araujoB105/BWRCprostheticArm/pictures/fingers.jpg

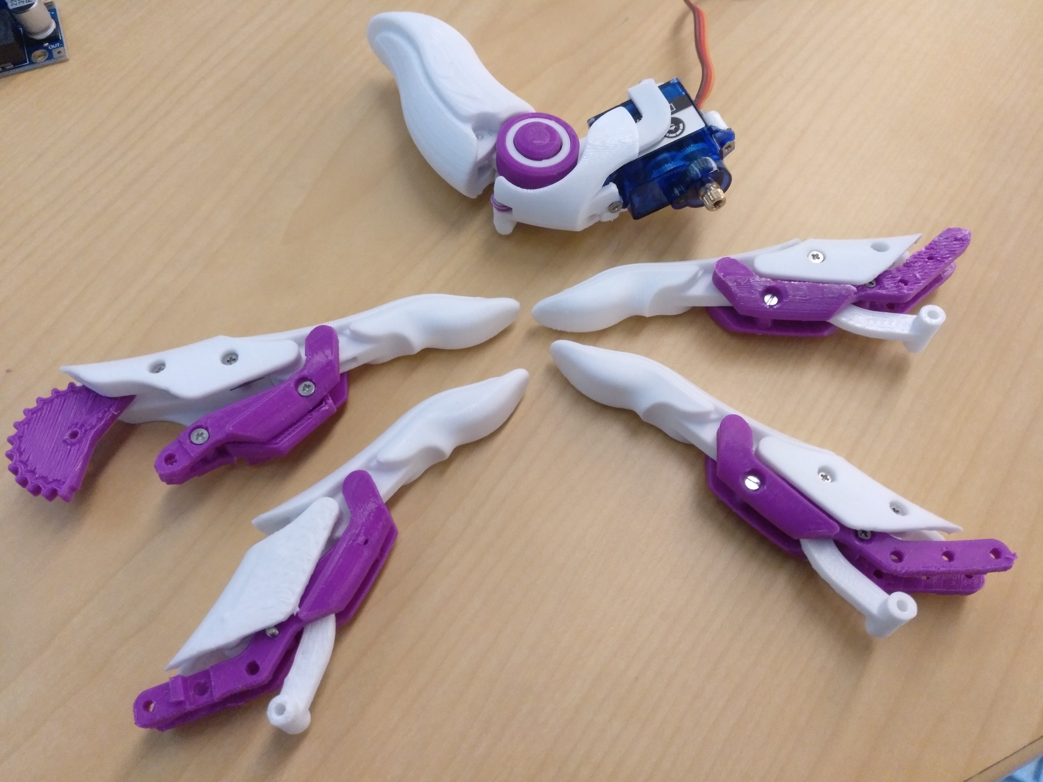
pictures/fingers.jpg
