araujoB105/BWRCprostheticArm/pictures/IMG_20180503_151149_356.jpg

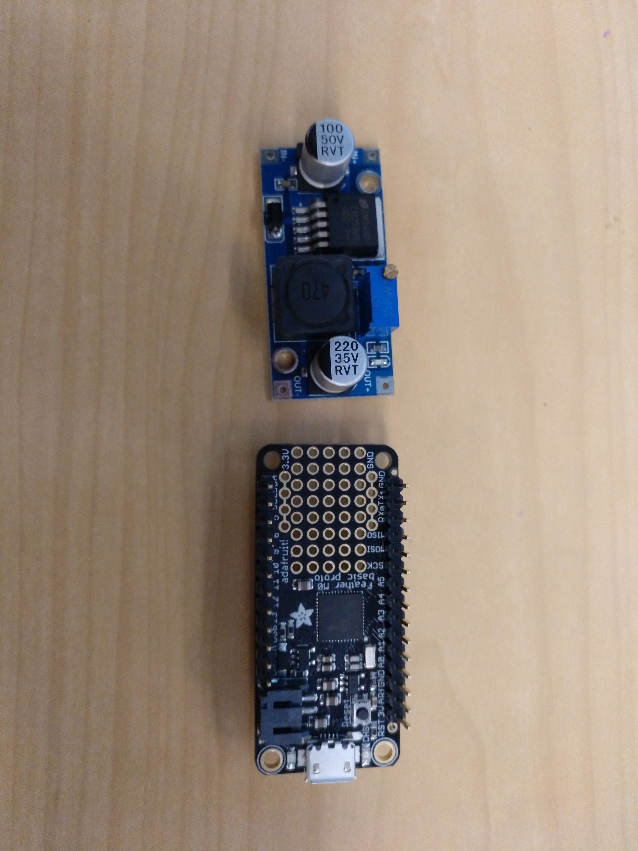
pictures/IMG_20180503_151149_356.jpg
