araujoB105/BWRCprostheticArm/pictures/battery_holder.jpg

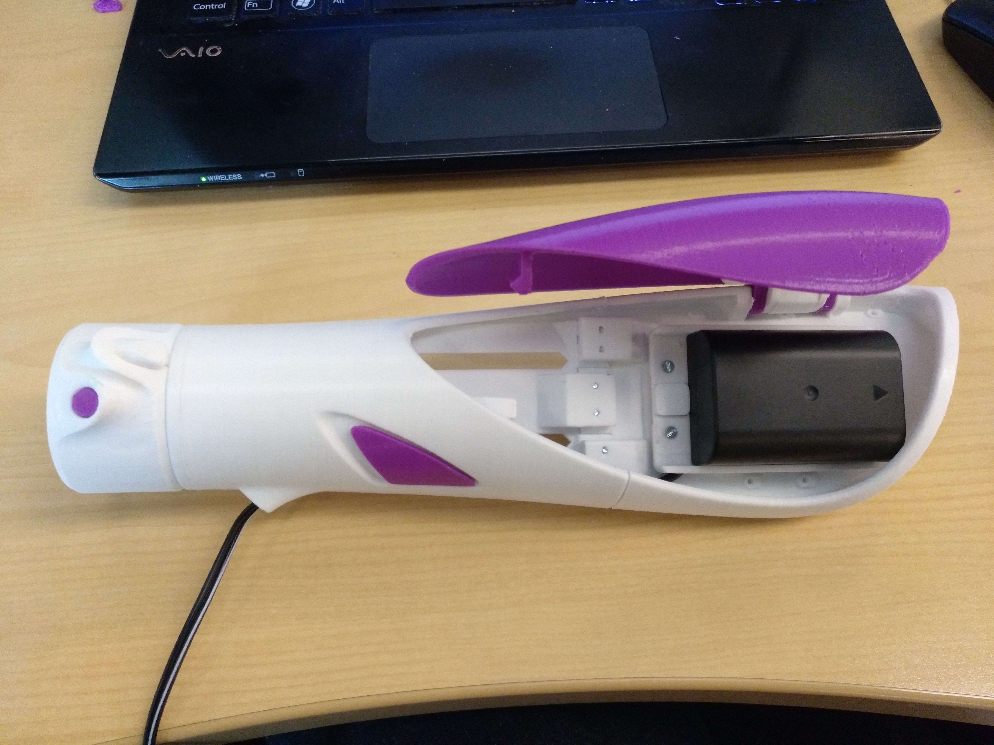
pictures/battery_holder.jpg
