araujoB105/BWRCprostheticArm/pictures/creation.jpg

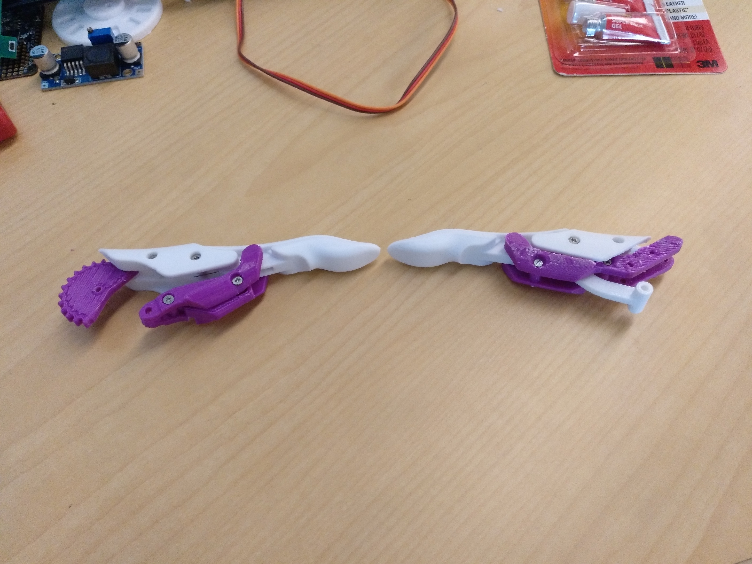
pictures/creation.jpg
