araujoB105/BWRCprostheticArm/pictures/driver.jpg

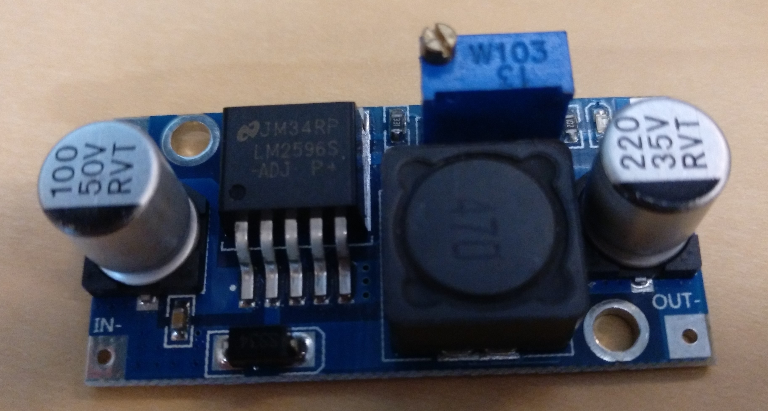
pictures/driver.jpg
