araujoB105/BWRCprostheticArm/pictures/feather.jpg

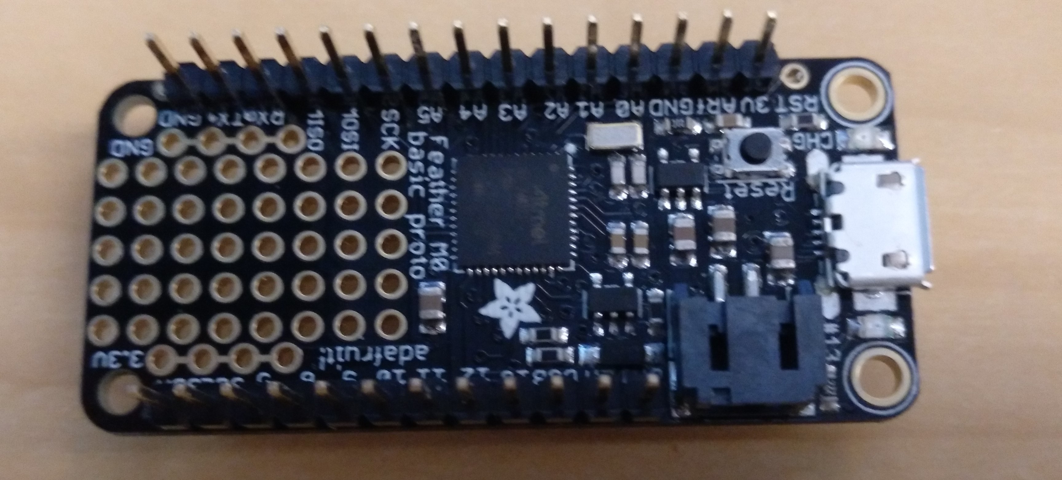
pictures/feather.jpg
