araujoB105/BWRCprostheticArm/pictures/full_arm2.jpg

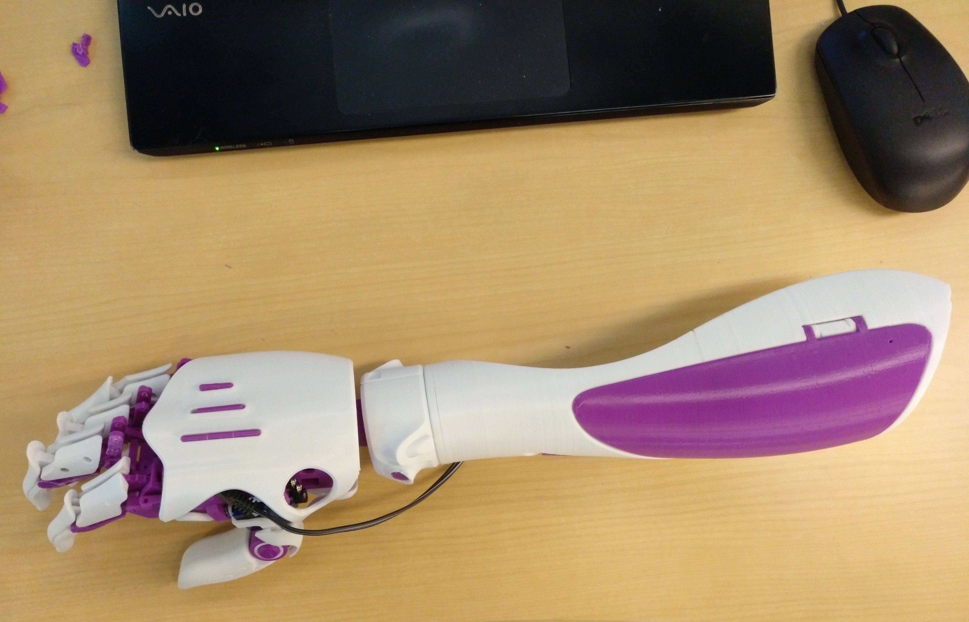
pictures/full_arm2.jpg
