araujoB105/BWRCprostheticArm/pictures/full_arm.jpg

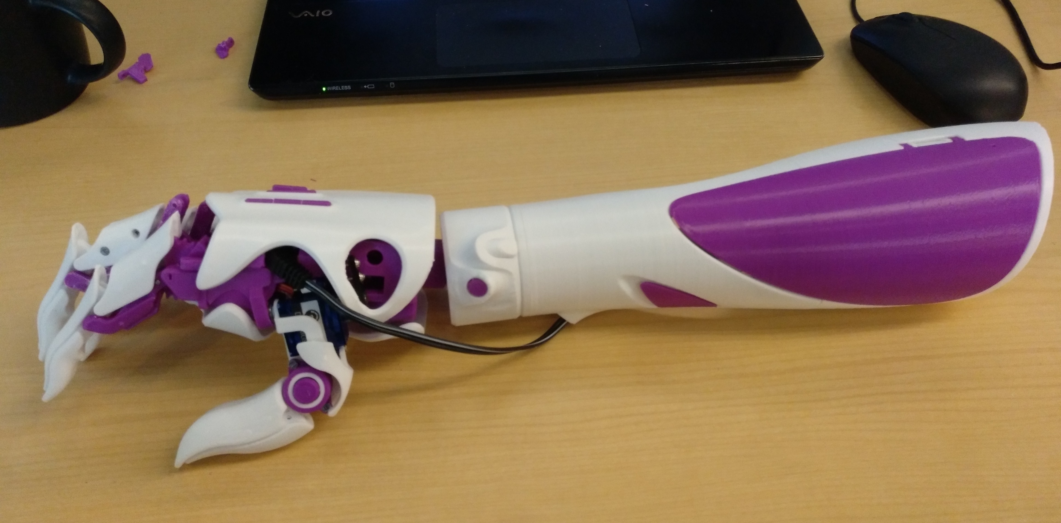
pictures/full_arm.jpg
