araujoB105/BWRCprostheticArm/pictures/hand_detail.jpg

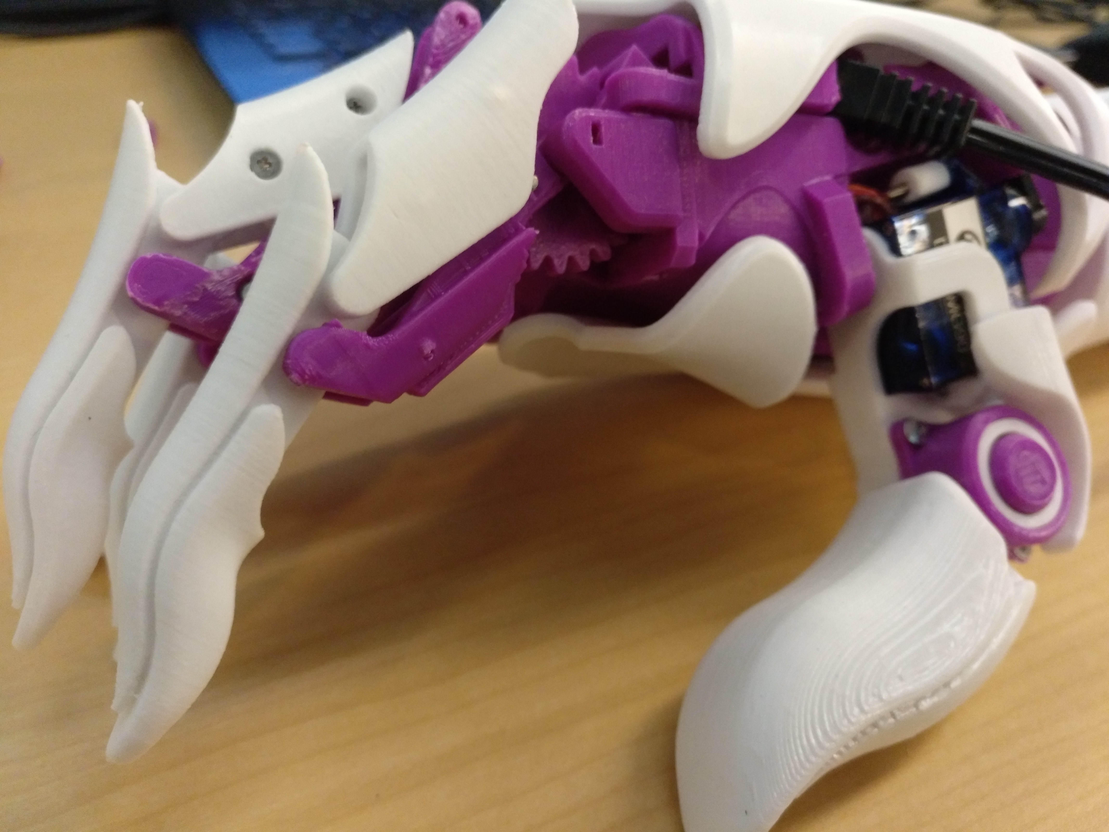
pictures/hand_detail.jpg
