araujoB105/BWRCprostheticArm/pictures/hand_OK.jpg

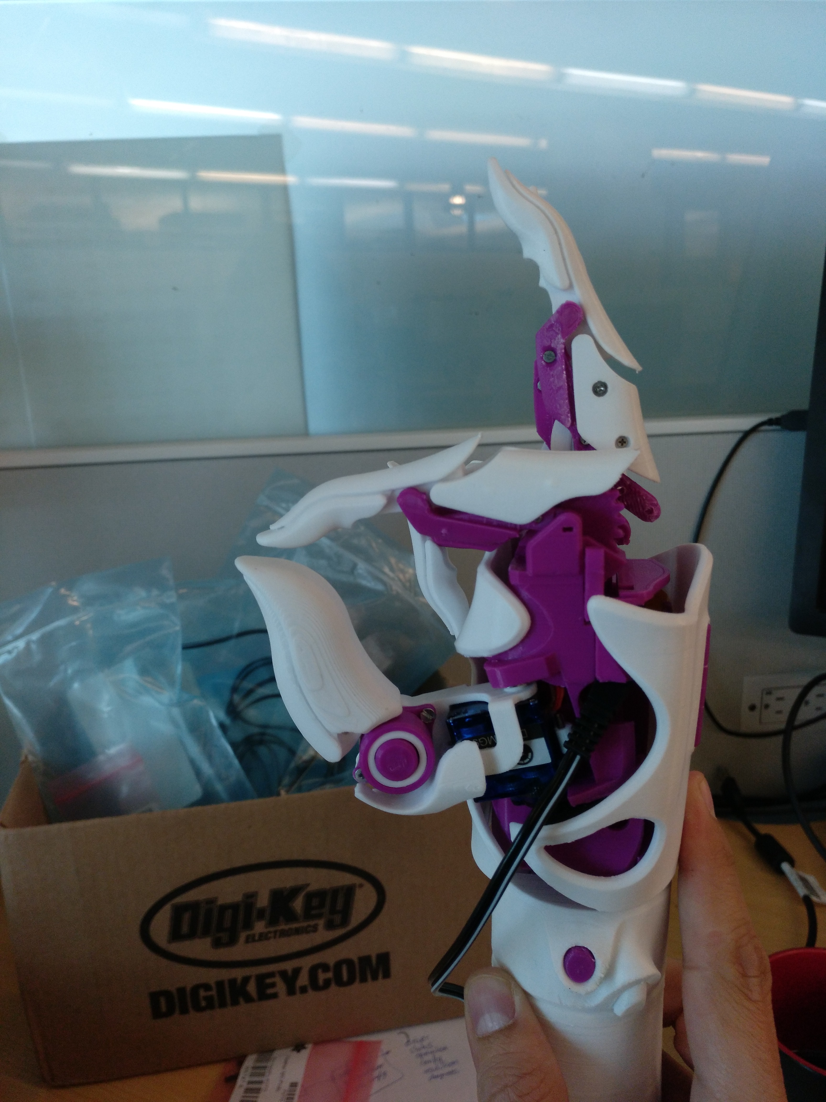
pictures/hand_OK.jpg
