araujoB105/BWRCprostheticArm/pictures/handBoard.jpg

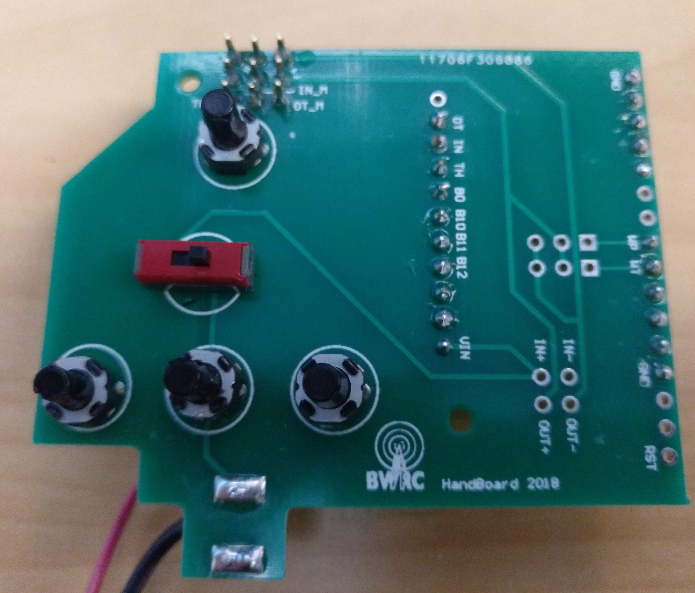
pictures/handBoard.jpg
