araujoB105/BWRCprostheticArm/pictures/IMG_20180503_150604_703.jpg

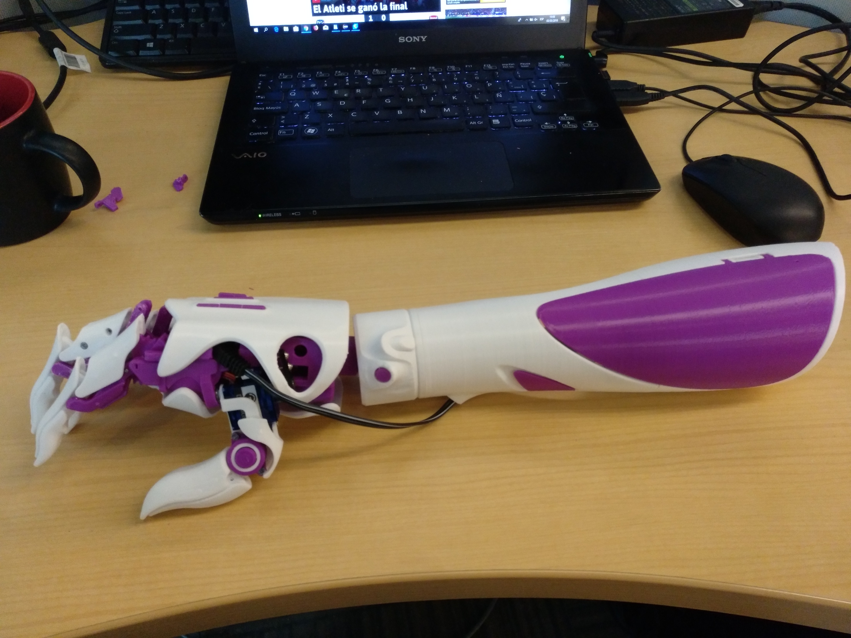
pictures/IMG_20180503_150604_703.jpg
