araujoB105/BWRCprostheticArm/pictures/IMG_20180503_150609_450.jpg

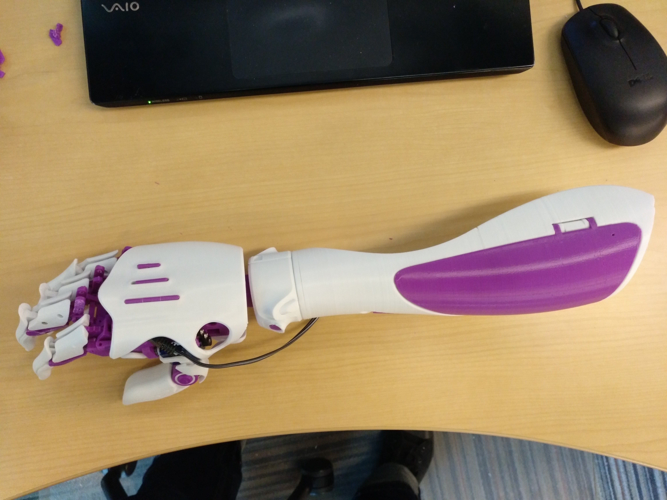
pictures/IMG_20180503_150609_450.jpg
