araujoB105/BWRCprostheticArm/pictures/IMG_20180503_150611_979.jpg

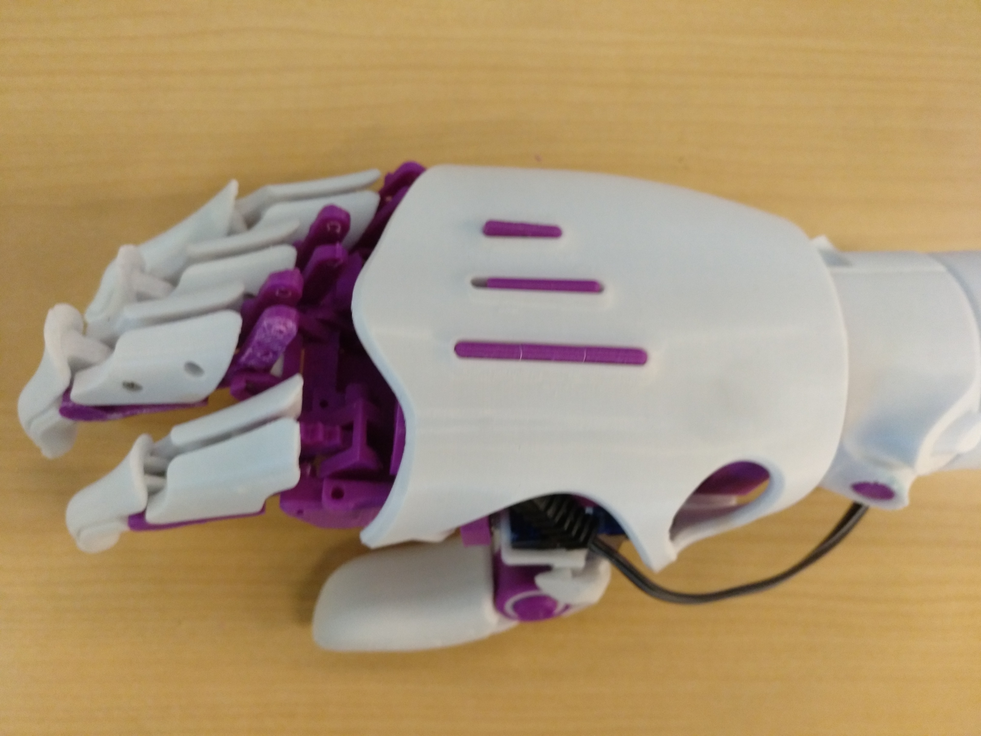
pictures/IMG_20180503_150611_979.jpg
