araujoB105/BWRCprostheticArm/pictures/IMG_20180503_151201_394.jpg

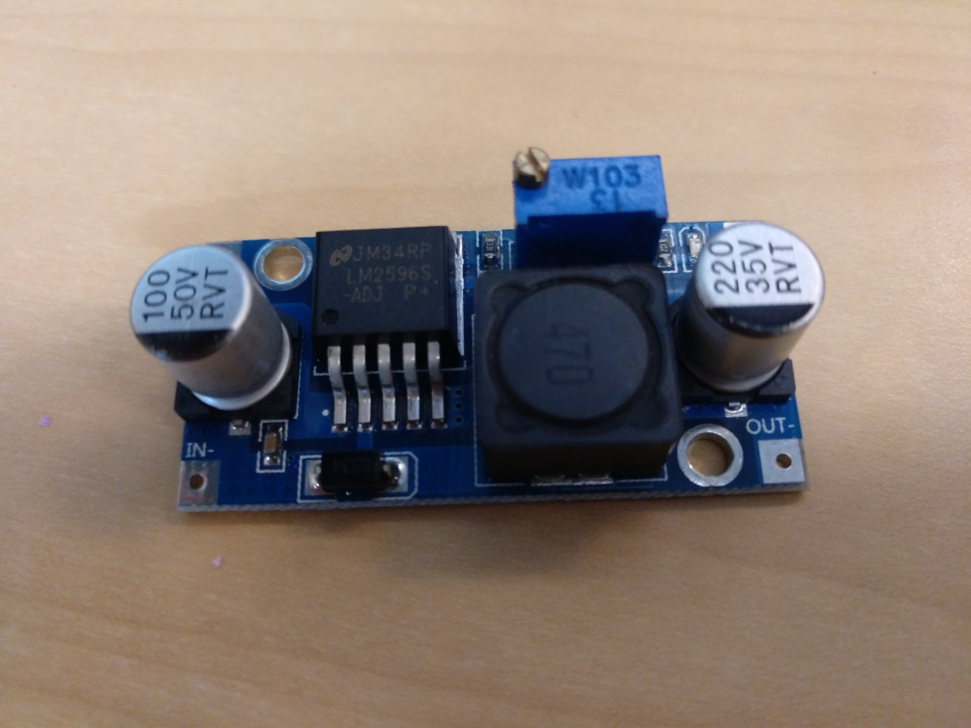
pictures/IMG_20180503_151201_394.jpg
