araujoB105/BWRCprostheticArm/pictures/IMG_20180503_155752_004.jpg

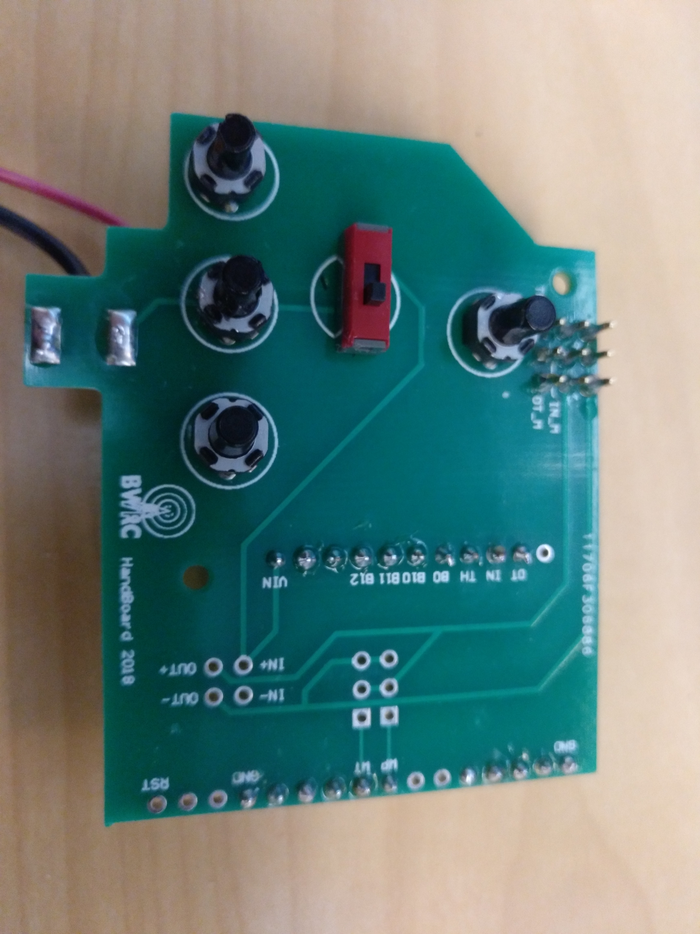
pictures/IMG_20180503_155752_004.jpg
