araujoB105/BWRCprostheticArm/pictures/retreat_pre_demo.MOV_files/dropbox_files-vfl7phztL.png

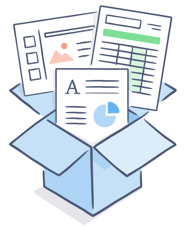
pictures/retreat_pre_demo.MOV_files/dropbox_files-vfl7phztL.png
