araujoB105/BWRCprostheticArm/hardware/ProstheticArmBOM.xlsx

Sheet: BOM
 | Description | Part number | Quantity | Distributor | Price (USD) | Digi-key
HAND
 | Battery and Charger | DMW-BLF19 | 2 | Amazon.com (http://www.amazon.com/dp/B00MP3MX7I/) | $11.00
 | Coil spring -Material diameter:0.5 -Outside diameter:6 -Free height:8 -Active coil turns:3 | CP 0.5-6-8 | 2 | Lee Spring [LCM050C 02 M] *haven't tested yet (http://www.leespring.com/product_spec.asp?partnum=LCM050C02M&springType=C&subType=) | $2.09
 | Tension spring -Material diameter:0.4 -Outside diameter:3.2 -Free length:14 | TS 0.4-3.2-14 (This part is only used for SocketU02) | 1 | Lee Spring [LE 014A 02 S] *haven't tested yet (http://www.leespring.com/product_spec.asp?partnum=LE014A02S&springType=E&subType=) | $2.40
 | Torsion spring -Material diameter:0.3 -Inside diameter:4 -Free Angle:270 -Active coil turns:5 -Arm length:12 | TOS 0.3-4-270-5 | 1 | Lee Spring [LTL012A 05 M] *haven't tested yet (http://www.leespring.com/product_spec.asp?partnum=LTL012A05M&springType=T&subType=) | $2.17
 | Steel ball -Spherical diameter:1/4" | SBI-SUJ-1d4 | 3 | Amazon.com (http://www.amazon.com/dp/B007B2AHM6/) | $2.58
 | Flat head tapping screw -Shaft diameter:2 -Head diameter:3.3 -Length:6 | flatScrewM2L6PHI3.3T1.3 | 50 | HW store | $3.40
 | Tapping screw -Shaft diameter:3 -Head diameter:5.5 -Length:8 | ScrewM3L8Btite | 12 | HW store | $1.39
 | Servo motor(small) | ES08MD | 2 | Digikey | $12.00 | 1738-1255-ND
 | Servo motor(large) | HD3001HB | 2 | Digikey | $20.00 | 1528-1083-ND
 | Resettable Fuses | RXEF050 | 4 | Digikey | $0.80 | RXEF050-1-ND
 | Resettable Fuses | RXEF040 | 2 | Digikey | $0.40 | RXEF040HF-ND
 | Bearing -Bore diameter:4 -Outside diameter -Width | UsmBearing | 3 | Amazon (https://www.amazon.com/10pcs-MF74zz-Flange-Sealed-Bearing/dp/B06W5VWYPJ) | $3.13
 | Tapping screw -Shaft diameter:2 -Head diameter:3.5 -Length:10 | ScrewM2L10 | 46 | HW store | $4.00
 | Spacer -Inside diameter:2.2 -Outside diameter:3.2 -Length:5 | MetalCollar | 20 | Amazon (https://www.amazon.com/ZSJ-Upgrading-Multicolored-Customized-Quadcopter/dp/B0722PT9GZ?s=industrial) | $2.00
 | Washer -Inside diameter:2.3 -Outside diameter:4.3 -Thickness:0.3 | WasherM2Ph4.3T0.3 | 10 | HW store | $1.00
 | Shaft -Diameter:2 -Length:10 | Shaft d2L10 (in 3d data, it is named as HbFingerPosture01) | 10 | Amazon (https://www.amazon.com/20Pcs-10mmx2mm-Stainless-Steel-Straight/dp/B00LUSTYOY?s=hi) | $2.30
 | Shaft -Diameter:2 -Length:15 | Shaft d2L15 (in 3d data, it is named as HbFingerPosture01) | 5 | Amazon (https://www.amazon.com/uxcell-50Pcs-Straight-Stainless-Steel/dp/B00LUT3J1W?s=hi) | $3.00
BatteryBoard
 | PCB | HbBatteryPcb01 | 1 |  | $5.00
 | DC Plug | MC2374L | 2 | Digikey | $9.00 | 486-3414-ND
 | Batt Contact probe | 101050-003 | 2 | Digikey | $0.65 | 36-2000-3-ND
 | Board | DC-DC | 1 | #VALUE! (https://www.amazon.com/Adjustable-Converter-1-5-35v-Efficiency-Regulator/dp/B07C2QF1T1?hvadid=241935719665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) | $1.62
HandBoard
 | Board | PWM | 1 | Adafruit (https://learn.adafruit.com/micropython-hardware-pca9685-pwm-and-servo-driver?view=all) | $9.95 | 1528-1531-ND
 | Board | Control-BLE | 1 | Adafruit (https://www.adafruit.com/product/2995) | $30.00
 | 2.54mm Female Header 1x22 | Pin Socket | 2 | Digikey | $1.00 | S7008-ND
 | 2.54mm male Header 1x3 | Pin Header | 6 | Digikey | $2.00 | S1131EC-40-ND
 | DC Jack | MJ179PH | 1 | Digikey | $0.87 | CP-002A-ND
 | Tace Switch | SKRGAQD010 | 0 | Digikey | $1.00 | P8085SCT-ND
 | Slide Switch | SS-12SDP2 | 0 | Digikey | $0.50 | 360-2133-ND
 | Lead Wire Cable 90mm |  | 2 | HW store | $0.50
 | Lead Wire Cable 50mm |  | 2 | HW store | $0.50
Wrist | Pan & tilt servos |  | 2 | Amazon (https://www.amazon.com/MINI-PAN-TILT-KIT-INCLUDED/dp/B00CBZ1GBY) | $16.00
TOTAL |  |  |  |  | $152.25 | ea

Sheet: 3Dprint
Unit | Part Name | Description | Quantity | Color
Hand | R-H-01.stl (or L-H-01.stl) | 3D print part (old name: HbWristMount01.stl) | 1 | sec
 | R-H-02a.stl (or L-H-02.stl) | 3D print part (old name: HbPalmBaseA.stl) | 1 | sec
 | R-H-02b.stl (or L-H-02.stl) | 3D print part (old name: HbPalmBaseB.stl)- Diff Color | 1 | main
 | R-H-03.stl (or L-H-03.stl) | 3D print part (old name: HbShaftStopperB04.stl) | 1 | sec
 | R-H-04.stl (or L-H-04.stl) | 3D print part (old name: HbShaftStopperA04.stl) | 1 | sec
 | R-H-05.stl (or L-H-05.stl) | 3D print part (old name: HbRing-LittleCouplerLink01.stl) | 1 | sec
 | R-H-06.stl (or L-H-06.stl) | 3D print part (old name: HbMiddle-RingCouplerLink01.stl) | 1 | sec
 | R-H-07.stl (or L-H-07.stl) | 3D print part (old name: HbFingerMainCouplerLink01.stl) | 1 | sec
 | R-H-08.stl (or L-H-08.stl) | 3D print part (old name: HbIndexMotorGear02.stl) | 1 | sec
 | R-H-09.stl (or L-H-09.stl) | 3D print part (old name: HbMotorHolder01.stl) | 1 | sec
 | R-H-10.stl (or L-H-10.stl) | 3D print part (old name: HbMaxButton05.stl) | 1 | sec
 | R-H-11.stl (or L-H-11.stl) | 3D print part (old name: HbMinButton05.stl) | 1 | sec
 | R-H-12.stl (or L-H-12.stl) | 3D print part (old name: HbThumbButton05.stl) | 1 | sec
 | R-H-13.stl (or L-H-13.stl) | 3D print part (old name: HbFingerLockButton05.stl) | 1 | sec
 | R-H-14.stl (or L-H-14.stl) | 3D print part (old name: HbPowerLever05.stl) | 1 | sec
 | R-H-15a.stl (or L-H-15.stl) | 3D print part (old name: HbBackCoverA.stl) | 1 | sec
 | R-H-15b.stl (or L-H-15.stl) | 3D print part (old name: HbBackCoverB.stl) - Diff Color | 1 | main
Socket | R-SO-01.stl (or L-SO-01.stl) | 3D print part (old name: HbMainFrameB01.stl) | 1 | main
 | R-SO-02.stl (or L-SO-02.stl) | 3D print part (old name: HbMainFrameA01.stl) | 1 | main
 | R-SO-03.stl (or L-SO-03.stl) | 3D print part (old name: HbBatteryLockKnob01.stl) | 1 | main
 | R-SO-04.stl (or L-SO-04.stl) | 3D print part (old name: HbBatteryCase01.stl) | 1 | main
 | R-SO-05.stl (or L-SO-05.stl) | 3D print part (old name: HbBatteryDoorKnob03.stl) | 1 | sec
 | R-SO-06.stl (or L-SO-06.stl) | 3D print part (old name: HbBatteryDoorLever03.stl) | 1 | main
 | R-SO-07.stl (or L-SO-07.stl) | 3D print part (old name: HbBatteryDoor03.stl) | 1 | sec
 | R-SO-08.stl (or L-SO-08.stl) | 3D print part (old name: HbBatteryHingeA03.stl) | 1 | main
 | R-SO-09.stl (or L-SO-09.stl) | 3D print part (old name: HbBatteryHingeB03.stl) | 1 | main
 | R-SO-10.stl (or L-SO-10.stl) | 3D print part (old name: HbBatteryHingeC03.stl) | 1 | main
Index Finger | R-I-01.stl (or L-I-01.stl) | 3D print part (old name: HbIndexMiddle-DistalPhalanx02.stl) | 1 | main
 | R-I-02.stl (or L-I-02.stl) | 3D print part (old name: HbIndexCouplerLinkCover02.stl) | 1 | main
 | R-I-03.stl (or L-I-03.stl) | 3D print part (old name: HbIndexInputLink02.stl) | 1 | sec
 | R-I-04.stl (or L-I-04.stl) | 3D print part (old name: HbIndexCouplerLink02.stl) | 1 | main
 | R-I-05.stl (or L-I-05.stl) | 3D print part (old name: HbIndexReleaseLever02.stl) | 1 | sec
 | R-I-06.stl (or L-I-06.stl) | 3D print part (old name: HbIndexProximalPhalanx03.stl) | 1 | sec
 | R-I-07.stl (or L-I-07.stl) | 3D print part (old name: HbIndexProximalPhalanxCover02.stl) | 1 | sec
Middle,Ring,Little Finger | R-O-01.stl (or L-O-01.stl) | 3D print part (old name: HbMiddle-DistalPhalanx02.stl) | 3 | main
 | R-O-02.stl (or L-O-02.stl) | 3D print part (old name: HbCouplerLinkCover03.stl) | 3 | main
 | R-O-03.stl (or L-O-03.stl) | 3D print part (old name: HbProximalPhalanx02.stl) | 3 | sec
 | R-O-04.stl (or L-O-04.stl) | 3D print part (old name: HbProximalPhalanxCover02.stl) | 3 | sec
 | R-O-05.stl (or L-O-05.stl) | 3D print part (old name: HbCouplerLink02.stl) | 3 | main
Thumb | R-T-01.stl (or L-T-01.stl) | 3D print part (old name: HbThumbProximalPhalanx02.stl) | 1 | main
 | R-T-02.stl (or L-T-02.stl) | 3D print part (old name: HbThumbProximalPhalanxBase02.stl) | 1 | main
 | R-T-03.stl (or L-T-03.stl) | 3D print part (old name: HbThumbMetacarpalPhalanx02.stl) | 1 | main
 | R-T-04.stl (or L-T-04.stl) | 3D print part (old name: HbThumbLockButton01.stl) | 1 | sec
 | R-T-05.stl (or L-T-05.stl) | 3D print part (old name: HbThumbJointHolder01.stl) | 1 | sec
 | R-T-06.stl (or L-T-06.stl) | 3D print part (old name: HbThumbMetacarpalPhalanxCover02.stl) | 1 | main
Wrist | R-W-01.stl (or L-W-01.stl) | 3D print part (old name: HBabductionLever02.stl) | 1 | sec
 | R-W-02.stl (or L-W-02.stl) | 3D print part (old name: HBarmMountBase03.stl) | 1 | main
 | R-W-03.stl (or L-W-03.stl) | 3D print part (old name: HBpronationLockPin02.stl) | 1 | main
 | R-W-04.stl (or L-W-04.stl) | 3D print part (old name: HBWristLockplate.stl) | 1 | main
 | R-W-05.stl (or L-W-05.stl) | 3D print part (old name: HBlockPlateHolder02.stl) | 1 | main
 | R-W-06.stl (or L-W-06.stl) | 3D print part (old name: HBejectorLever02.stl) | 1 | sec
 | R-W-07.stl (or L-W-07.stl) | 3D print part (old name: HbArmMountU01.stl) | 1 | main
 | R-W-08.stl (or L-W-08.stl) | 3D print part (old name: HBarmMountBaseCover03.stl) | 1 | main
Settings
Layer | Thickness 0,1mm
Use raft
Thick support to allow overhangs, archers, etc
Infill | 50% small pieces, 30% big ones
