araujoB105/BWRCprostheticArm/3Dmodel/STEP/C-SE.stp

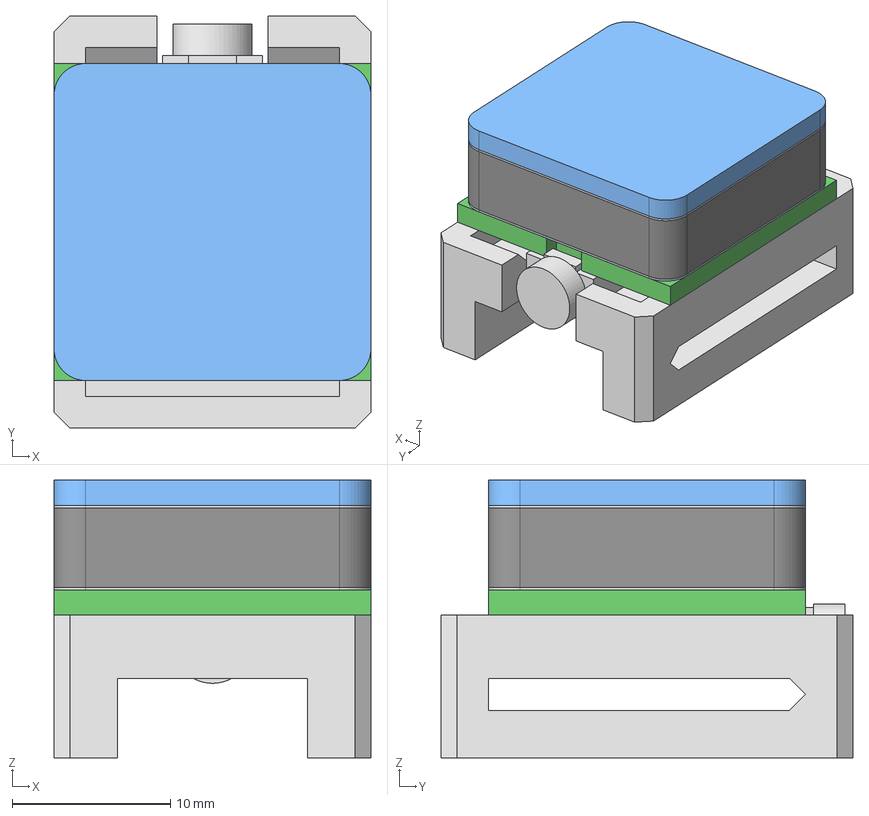
[picture p19: CAD file, 2018-07-25]
3Dmodel/STEP/C-SE.stp
20.0 x 26.0 x 17.5 mm
C-SE-01 v1
HbSensorBoard02
ST-PJ-312
HbSensorCushion02
QRE1113GR
HbSensorTape01 x 2
C-SE-02 v1
