araujoB105/BWRCprostheticArm/3Dmodel/STL/2colors/main/R-SO-10done.stl

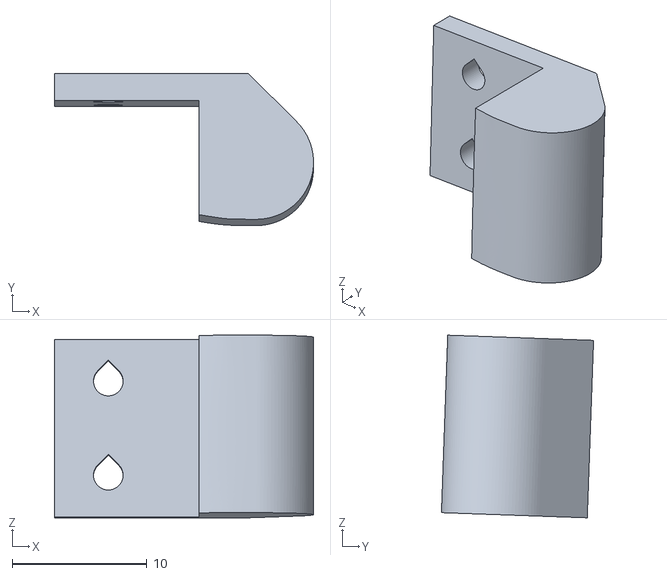
[picture p20: CAD file, 2018-07-25]
3Dmodel/STL/2colors/main/R-SO-10done.stl
19.2 x 11.3 x 13.6
