araujoB105/BWRCprostheticArm/3Dmodel/STL/2colors/secondary/R-H-13.stl

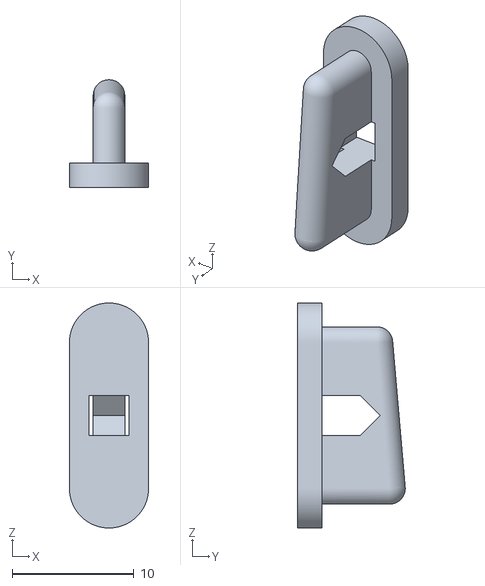
[picture p21: CAD file, 2018-07-25]
3Dmodel/STL/2colors/secondary/R-H-13.stl
6.51 x 8.85 x 18.5
