araujoB105/BWRCprostheticArm/3Dmodel/STL/Common/B/C-B-02.stl

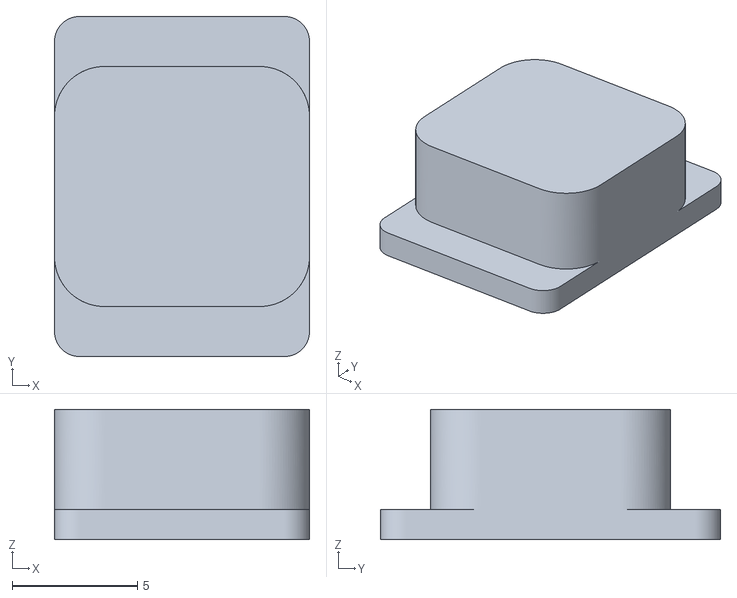
[picture p22: CAD file, 2018-07-25]
3Dmodel/STL/Common/B/C-B-02.stl
10.2 x 13.6 x 5.20
