araujoB105/BWRCprostheticArm/3Dmodel/STL/Common/SE/C-SE-02.stl

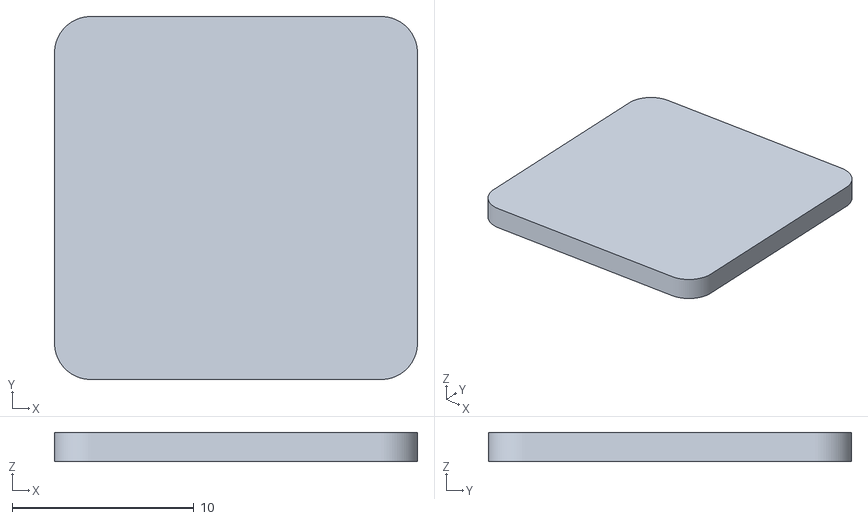
[picture p23: CAD file, 2018-07-25]
3Dmodel/STL/Common/SE/C-SE-02.stl
20.0 x 20.0 x 1.60
