araujoB105/BWRCprostheticArm/3Dmodel/STL/Left/Hand/L-H-11.stl

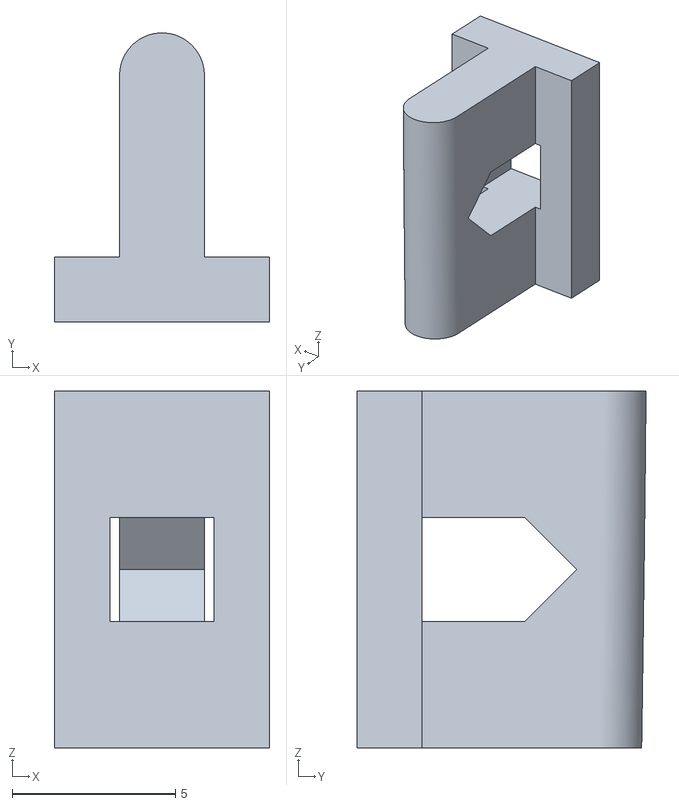
[picture p24: CAD file, 2018-07-25]
3Dmodel/STL/Left/Hand/L-H-11.stl
6.60 x 8.87 x 10.9
