araujoB105/BWRCprostheticArm/3Dmodel/STL/Left/Indexfinger/L-I-02.stl

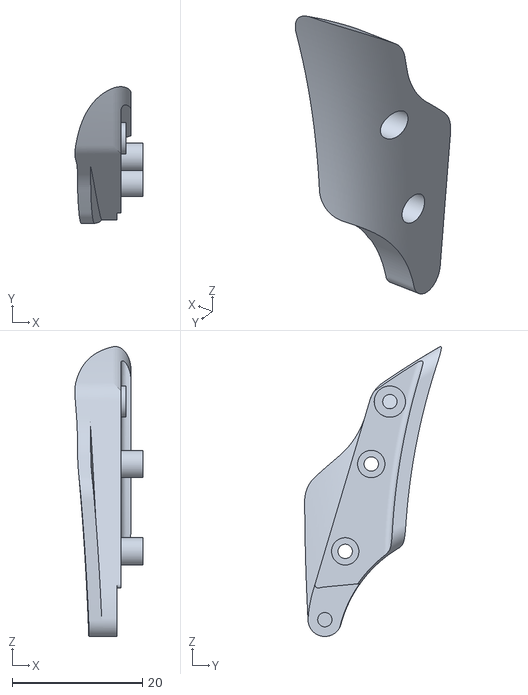
[picture p25: CAD file, 2018-07-25]
3Dmodel/STL/Left/Indexfinger/L-I-02.stl
10.5 x 21.0 x 44.5
