araujoB105/BWRCprostheticArm/3Dmodel/STL/Left/Otherfingers/L-O-04.stl

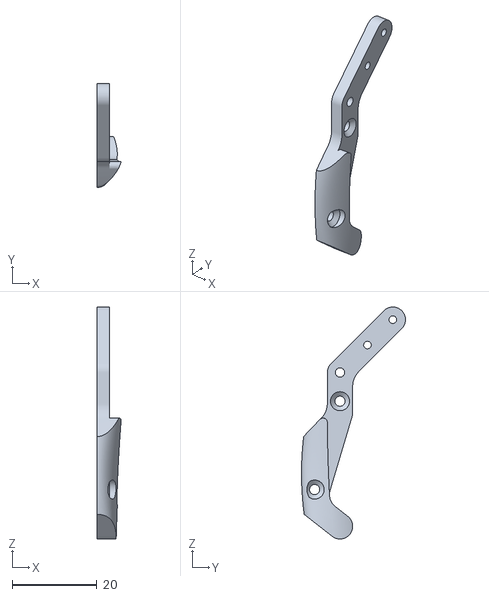
[picture p26: CAD file, 2018-07-25]
3Dmodel/STL/Left/Otherfingers/L-O-04.stl
5.69 x 24.6 x 54.9
