araujoB105/BWRCprostheticArm/3Dmodel/STL/Left/Socket/L-SO-04.stl

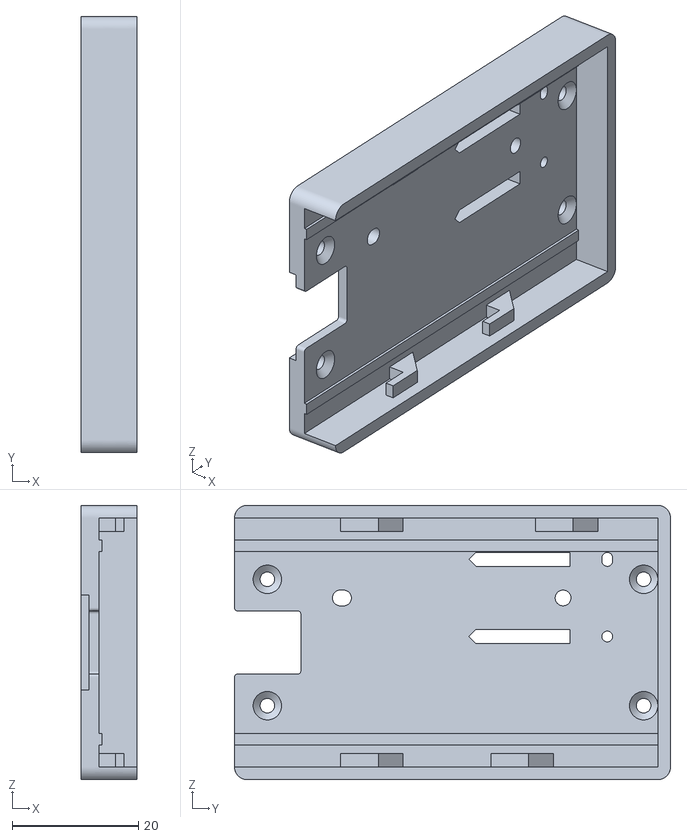
[picture p27: CAD file, 2018-07-25]
3Dmodel/STL/Left/Socket/L-SO-04.stl
8.90 x 69.0 x 43.4
