araujoB105/BWRCprostheticArm/3Dmodel/STL/Left/Thumbfinger/L-T-03.stl

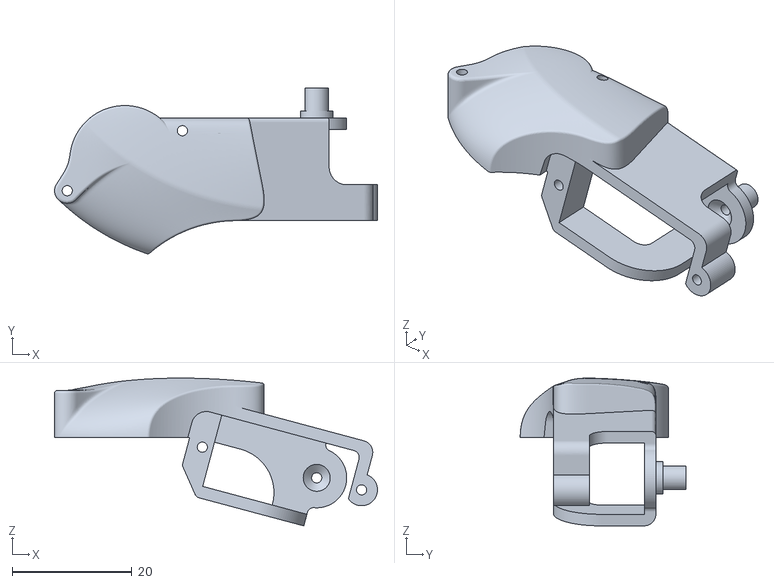
[picture p28: CAD file, 2018-07-25]
3Dmodel/STL/Left/Thumbfinger/L-T-03.stl
53.9 x 27.6 x 24.6
