araujoB105/BWRCprostheticArm/3Dmodel/STL/Left/Wrist/L-W-04.stl

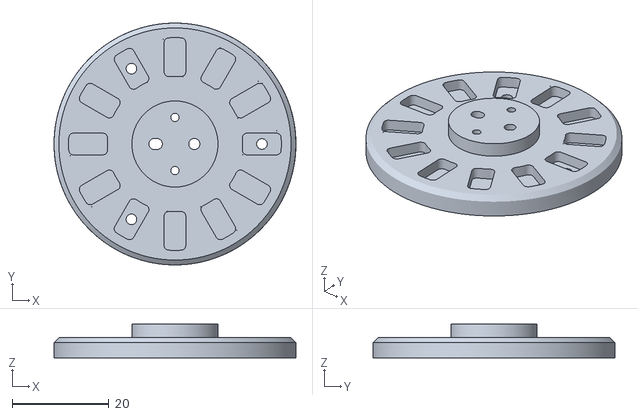
[picture p29: CAD file, 2018-07-25]
3Dmodel/STL/Left/Wrist/L-W-04.stl
50.0 x 50.0 x 7.00
