araujoB105/BWRCprostheticArm/3Dmodel/STL/palmDiffColor/HbPalmBaseA_STL.stl

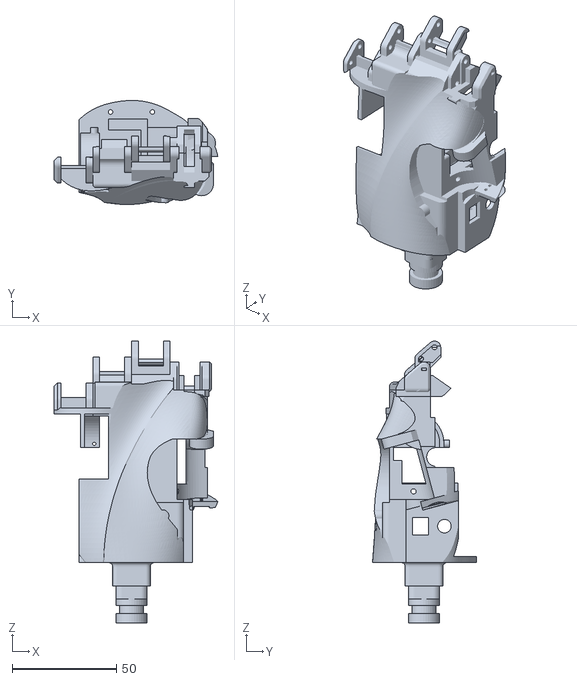
[picture p30: CAD file, 2018-07-25]
3Dmodel/STL/palmDiffColor/HbPalmBaseA_STL.stl
78.3 x 49.8 x 134.9
