araujoB105/BWRCprostheticArm/3Dmodel/STL/Right/Hand/R-H-12.stl

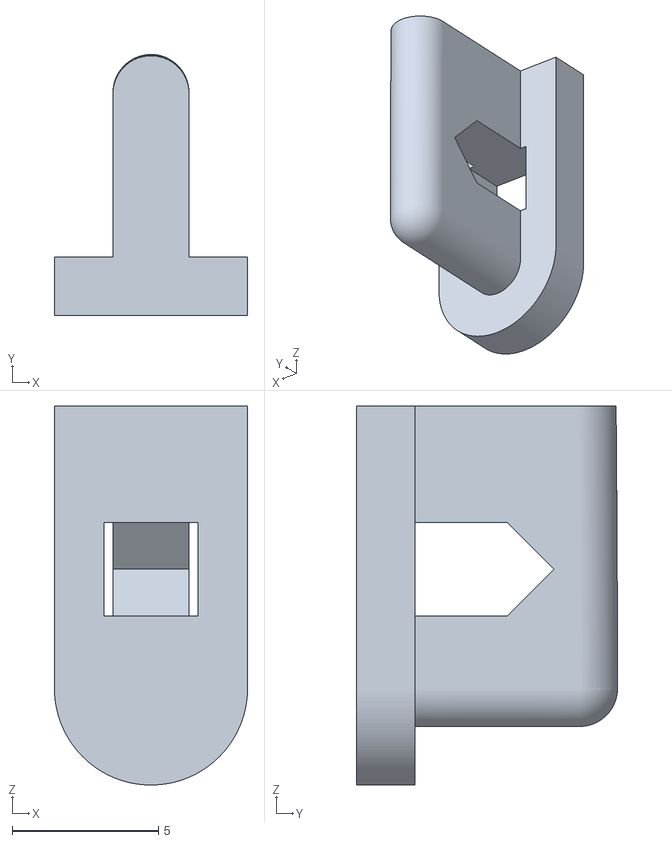
[picture p31: CAD file, 2018-07-25]
3Dmodel/STL/Right/Hand/R-H-12.stl
6.60 x 8.92 x 12.9
