araujoB105/BWRCprostheticArm/3Dmodel/STL/Right/Indexfinger/R-I-04.stl

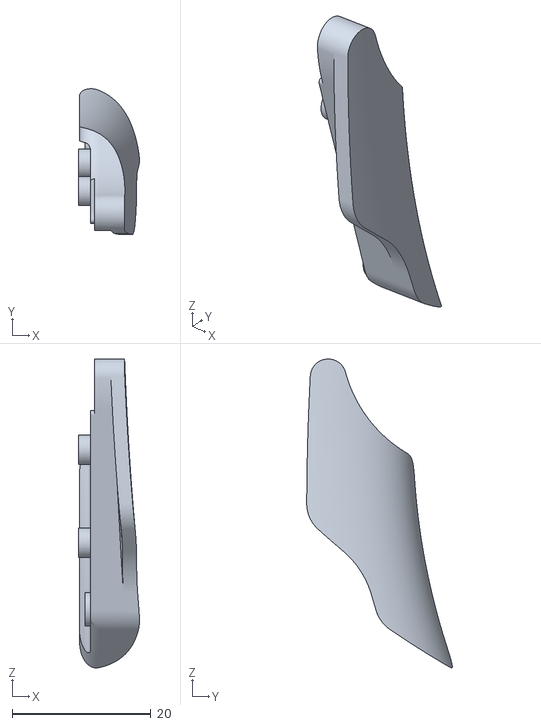
[picture p32: CAD file, 2018-07-25]
3Dmodel/STL/Right/Indexfinger/R-I-04.stl
8.77 x 21.0 x 44.5
