araujoB105/BWRCprostheticArm/3Dmodel/STL/Right/Socket/R-SO-05.stl

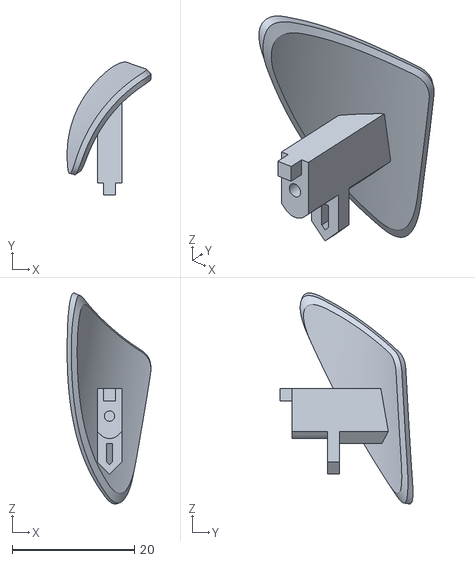
[picture p33: CAD file, 2018-07-25]
3Dmodel/STL/Right/Socket/R-SO-05.stl
13.7 x 21.8 x 34.6
