araujoB105/BWRCprostheticArm/3Dmodel/STL/Right/Thumbfinger/R-T-05.stl

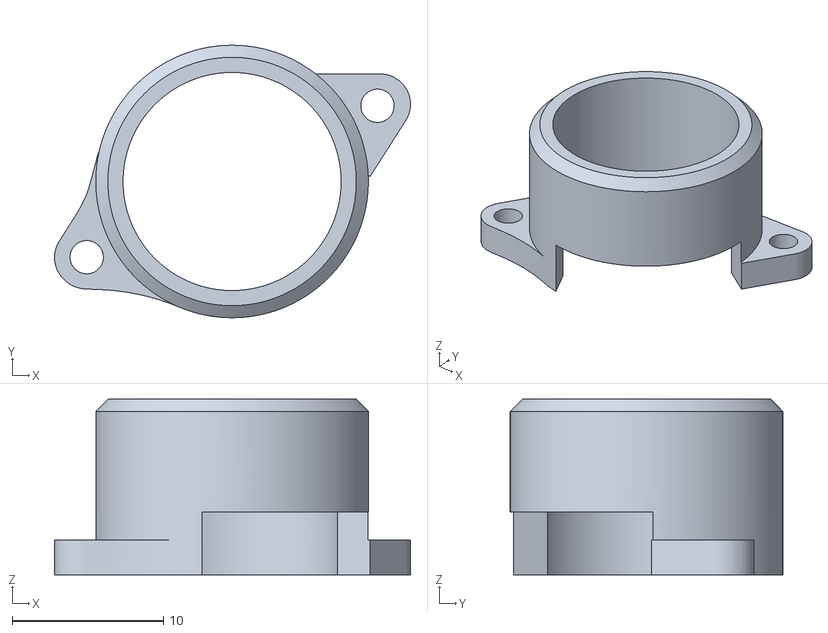
[picture p34: CAD file, 2018-07-25]
3Dmodel/STL/Right/Thumbfinger/R-T-05.stl
23.5 x 18.0 x 11.6
