araujoB105/BWRCprostheticArm/3Dmodel/STEP/C-B.stp

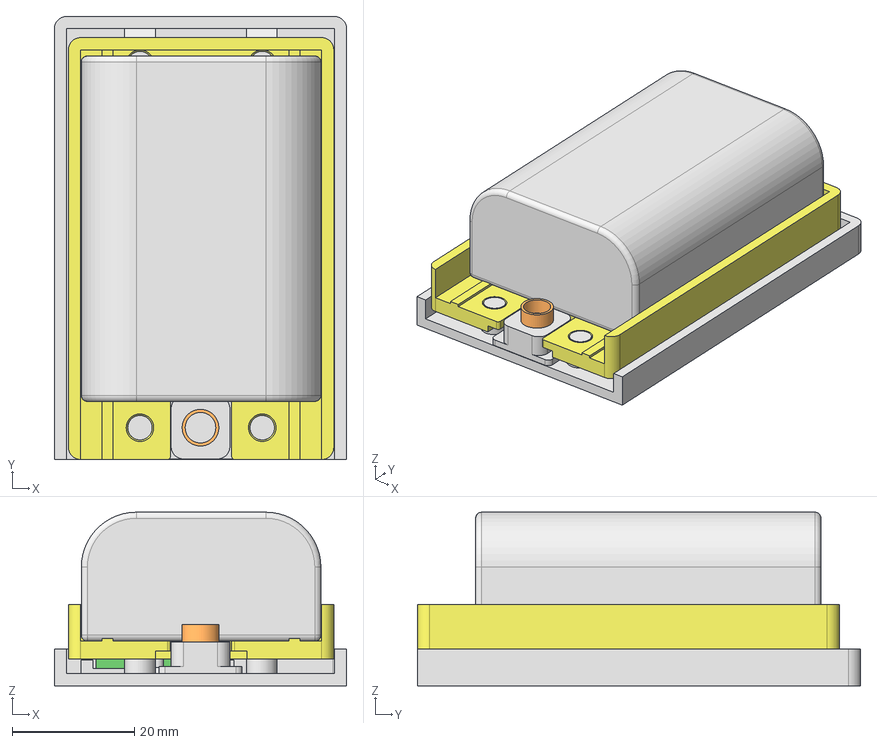
[picture p35: CAD file, 2018-07-25]
3Dmodel/STEP/C-B.stp
47.8 x 72.5 x 28.4 mm
C-B-01 v1
C-B-02 v1
CP 0 v1
HbBatteryPcb02 v1
101050-003 v1 x 2
C-B-03 v1
flatScrewM2L6PHI3.3T1 v1 x 4
DMW-BLF19 v1
