araujoB105/BWRCprostheticArm/3Dmodel/STL/2colors/secondary/R-H-07.stl

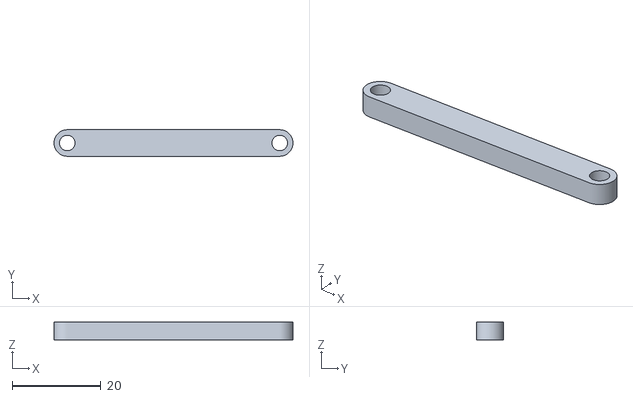
[picture p36: CAD file, 2018-07-25]
3Dmodel/STL/2colors/secondary/R-H-07.stl
54.0 x 6.00 x 4.00
