araujoB105/BWRCprostheticArm/3Dmodel/STL/Common/B/C-B-01.stl

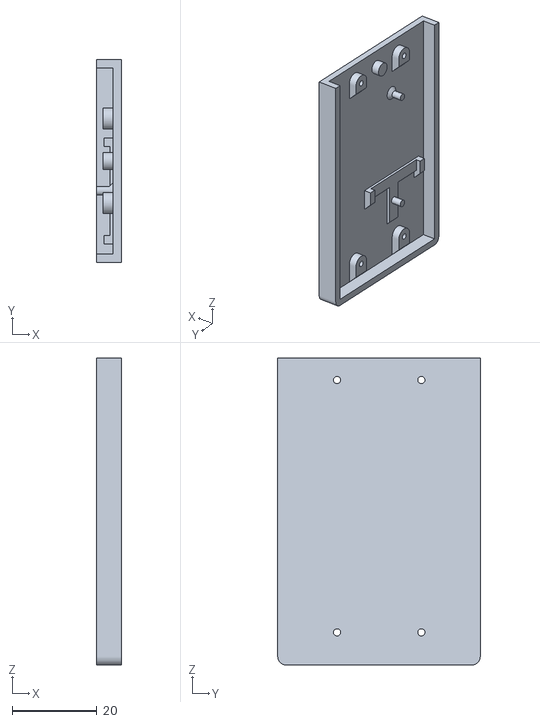
[picture p37: CAD file, 2018-07-25]
3Dmodel/STL/Common/B/C-B-01.stl
6.00 x 47.8 x 72.5
