araujoB105/BWRCprostheticArm/3Dmodel/STL/Common/SE/C-SE-01.stl

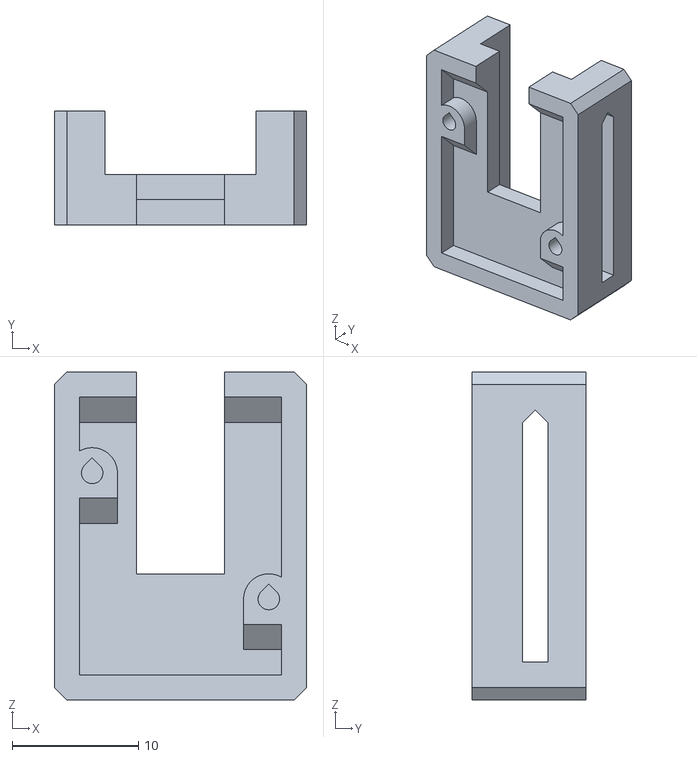
[picture p38: CAD file, 2018-07-25]
3Dmodel/STL/Common/SE/C-SE-01.stl
20.0 x 9.00 x 26.0
