araujoB105/BWRCprostheticArm/3Dmodel/STL/Left/Hand/L-H-01.stl

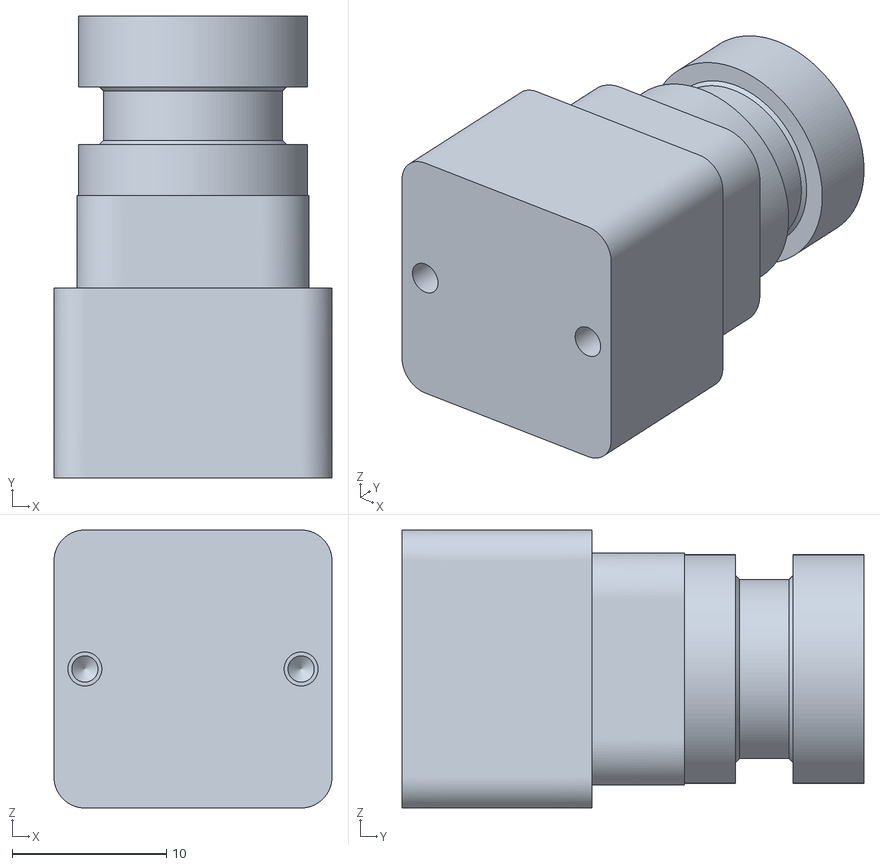
[picture p39: CAD file, 2018-07-25]
3Dmodel/STL/Left/Hand/L-H-01.stl
18.0 x 29.9 x 18.0
