araujoB105/BWRCprostheticArm/3Dmodel/STL/Left/Indexfinger/L-I-06.stl

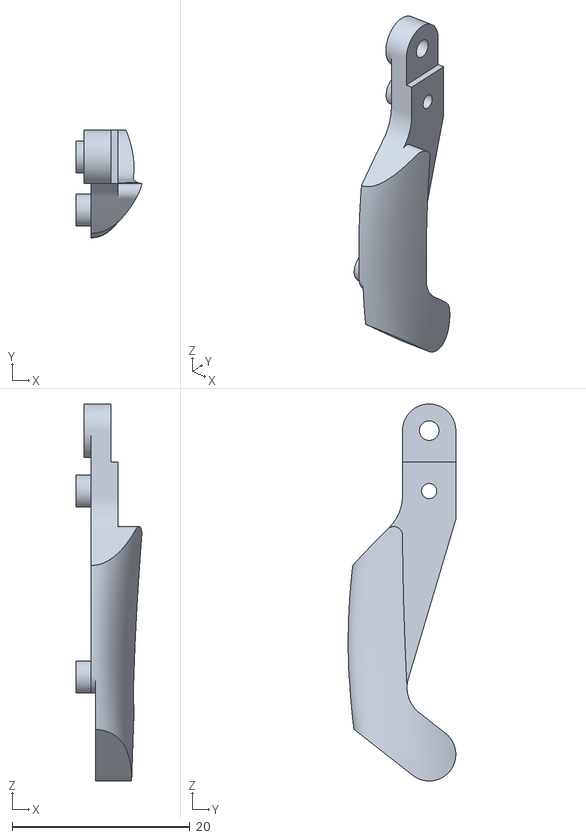
[picture p40: CAD file, 2018-07-25]
3Dmodel/STL/Left/Indexfinger/L-I-06.stl
7.39 x 12.1 x 42.4
