araujoB105/BWRCprostheticArm/3Dmodel/STL/Left/Otherfingers/L-O-02.stl

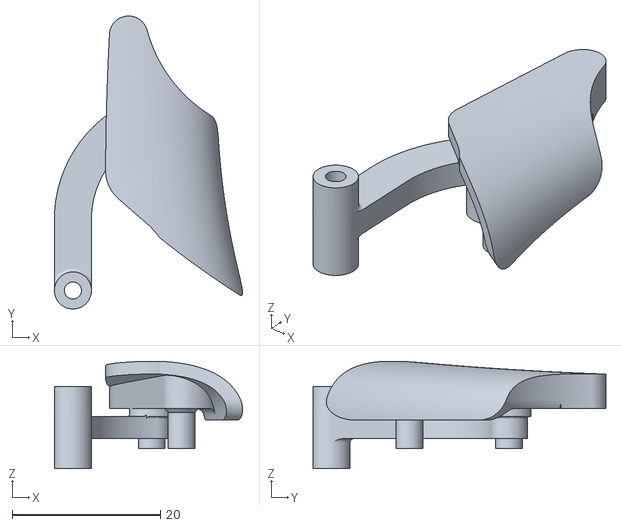
[picture p41: CAD file, 2018-07-25]
3Dmodel/STL/Left/Otherfingers/L-O-02.stl
25.4 x 39.5 x 14.5
