araujoB105/BWRCprostheticArm/3Dmodel/STL/Left/Thumbfinger/L-T-06.stl

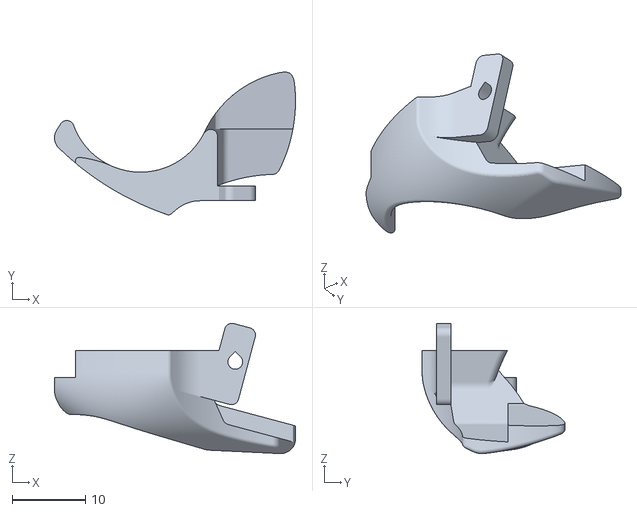
[picture p42: CAD file, 2018-07-25]
3Dmodel/STL/Left/Thumbfinger/L-T-06.stl
32.9 x 19.5 x 17.8
