araujoB105/BWRCprostheticArm/3Dmodel/STL/Left/Wrist/L-W-05.stl

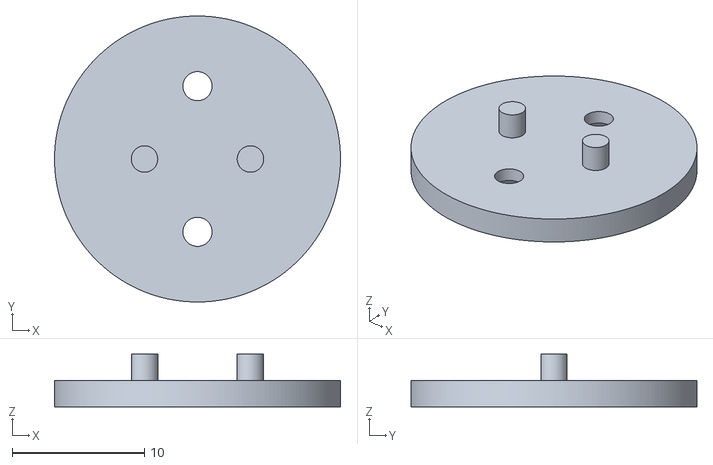
[picture p43: CAD file, 2018-07-25]
3Dmodel/STL/Left/Wrist/L-W-05.stl
21.6 x 21.6 x 4.00
