araujoB105/BWRCprostheticArm/3Dmodel/STL/palmDiffColor/HbBackCoverA_STL.stl

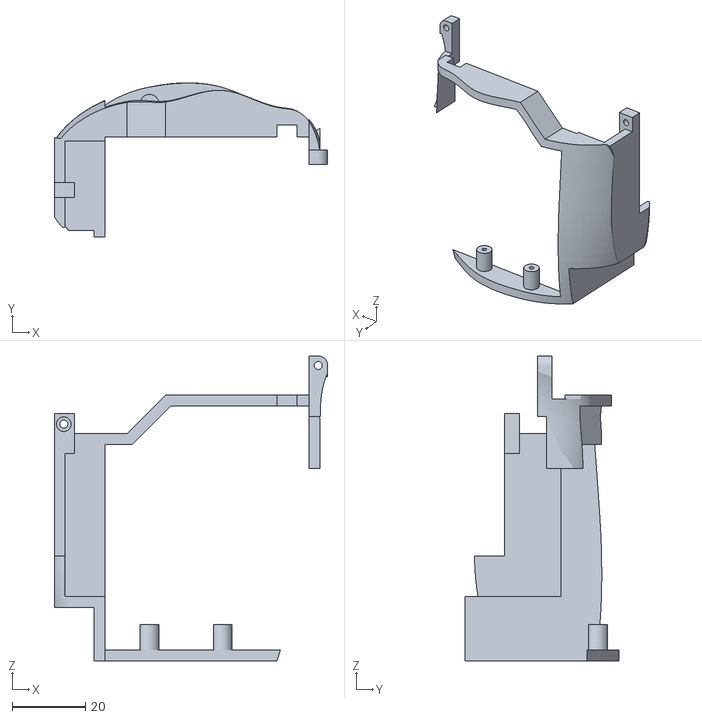
[picture p44: CAD file, 2018-07-25]
3Dmodel/STL/palmDiffColor/HbBackCoverA_STL.stl
74.7 x 42.2 x 83.3
