araujoB105/BWRCprostheticArm/3Dmodel/STL/Right/Hand/R-H-08.stl

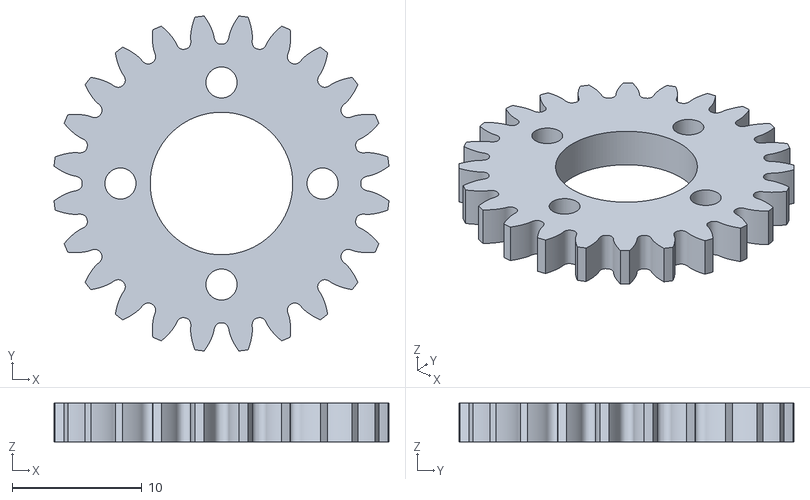
[picture p45: CAD file, 2018-07-25]
3Dmodel/STL/Right/Hand/R-H-08.stl
25.9 x 25.9 x 3.00
