araujoB105/BWRCprostheticArm/3Dmodel/STL/Right/Indexfinger/R-I-05.stl

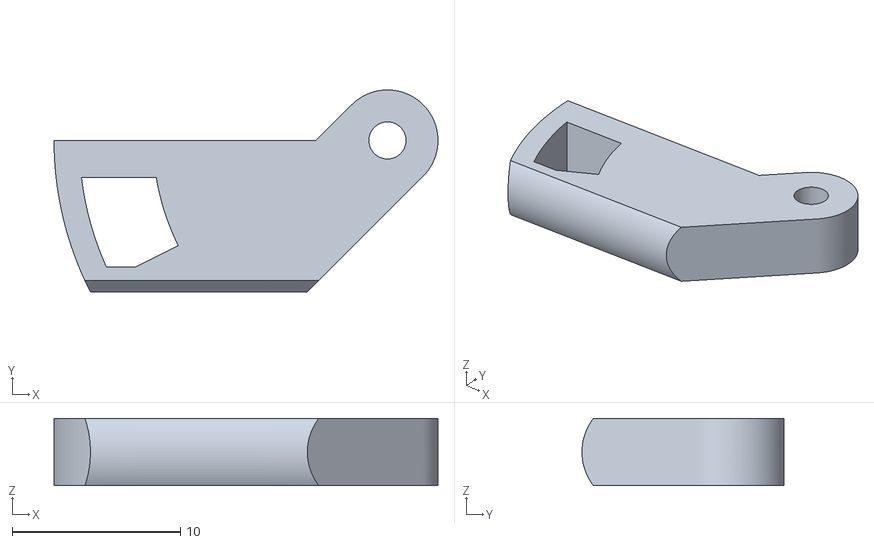
[picture p46: CAD file, 2018-07-25]
3Dmodel/STL/Right/Indexfinger/R-I-05.stl
22.8 x 12.0 x 4.00
