araujoB105/BWRCprostheticArm/3Dmodel/STL/Right/Otherfingers/R-O-03.stl

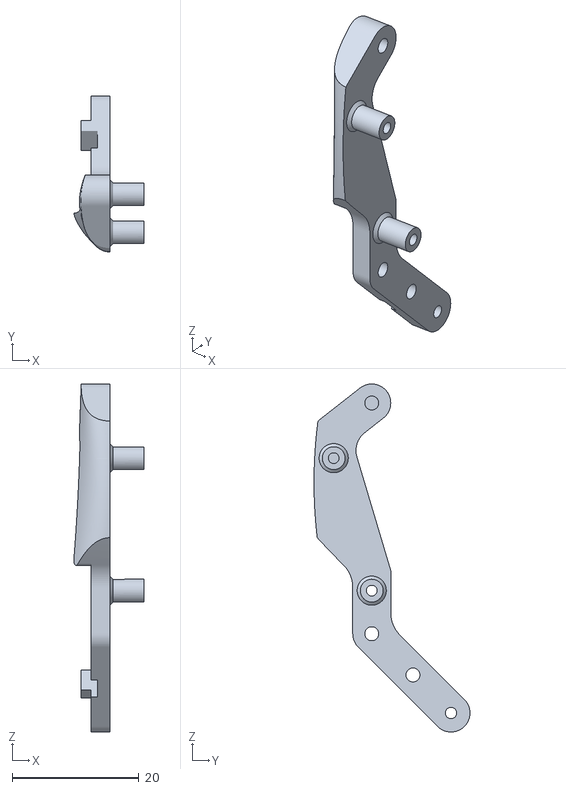
[picture p47: CAD file, 2018-07-25]
3Dmodel/STL/Right/Otherfingers/R-O-03.stl
11.1 x 24.6 x 54.9
