araujoB105/BWRCprostheticArm/3Dmodel/STL/Right/Socket/R-SO-09.stl

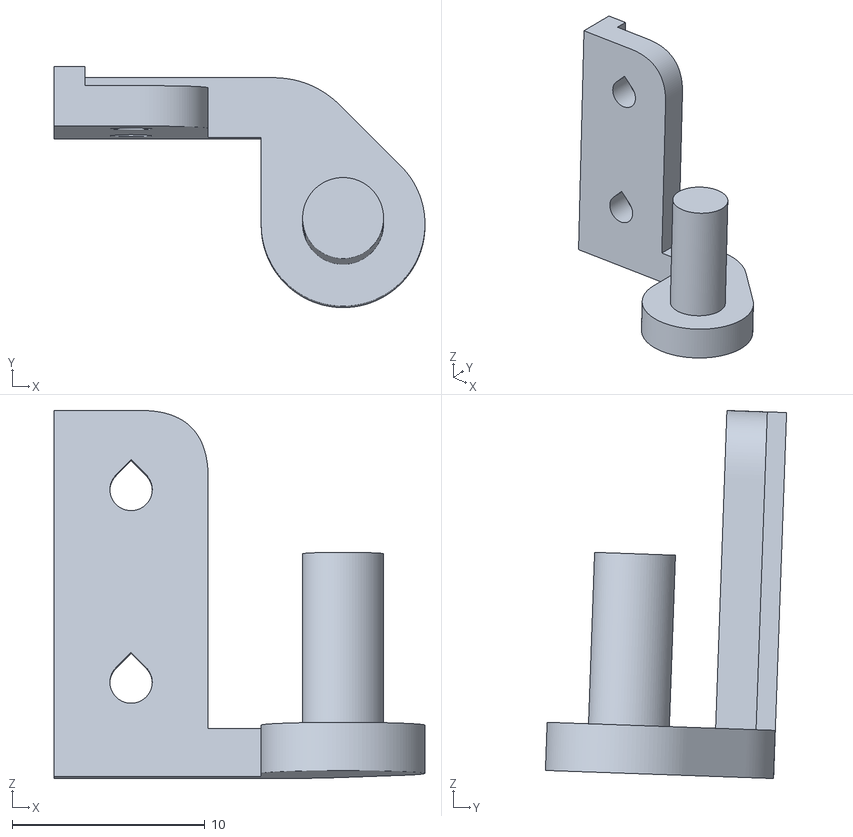
[picture p48: CAD file, 2018-07-25]
3Dmodel/STL/Right/Socket/R-SO-09.stl
19.2 x 12.5 x 19.1
