araujoB105/BWRCprostheticArm/3Dmodel/STL/Right/Thumbfinger/R-T-01.stl

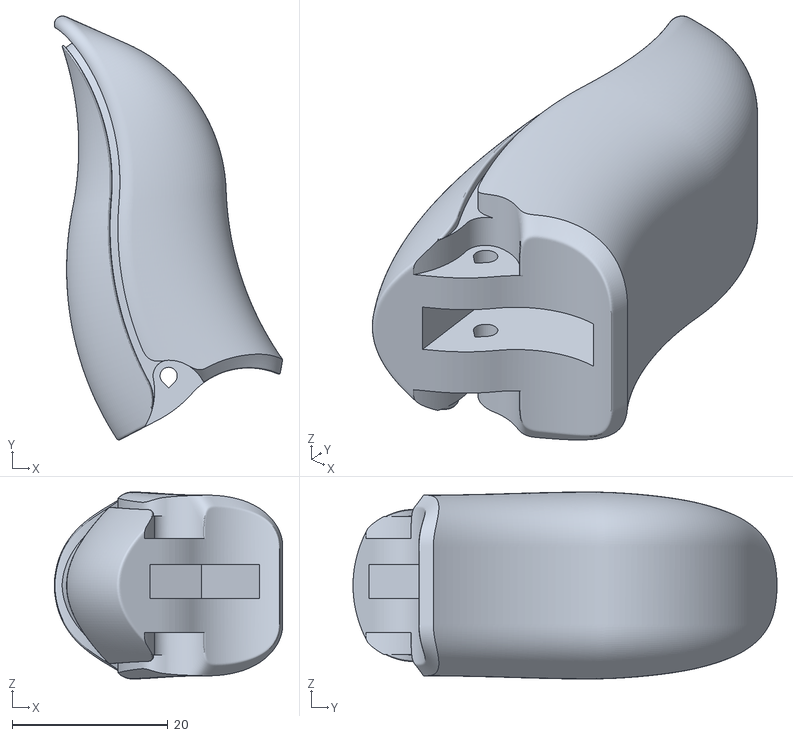
[picture p49: CAD file, 2018-07-25]
3Dmodel/STL/Right/Thumbfinger/R-T-01.stl
29.3 x 54.4 x 24.0
