araujoB105/BWRCprostheticArm/3Dmodel/STL/Right/Wrist/R-W-02.stl

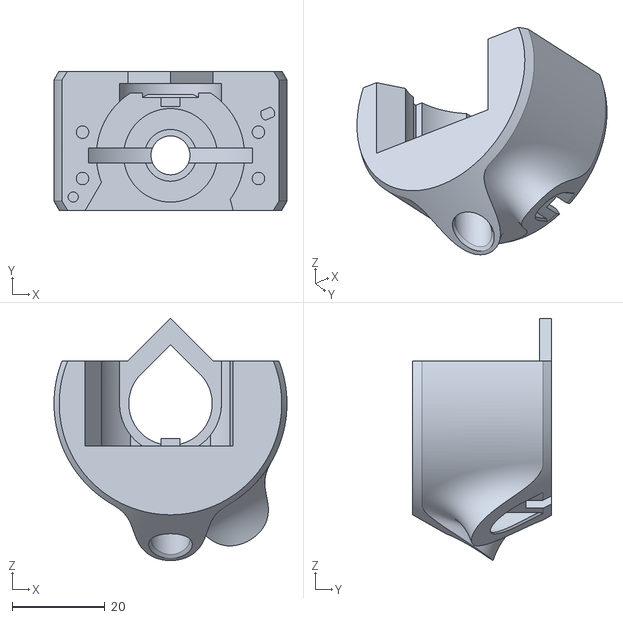
[picture p50: CAD file, 2018-07-25]
3Dmodel/STL/Right/Wrist/R-W-02.stl
50.3 x 30.0 x 52.3
