araujoB105/BWRCprostheticArm/3Dmodel/STL/2colors/main/R-W-08.stl

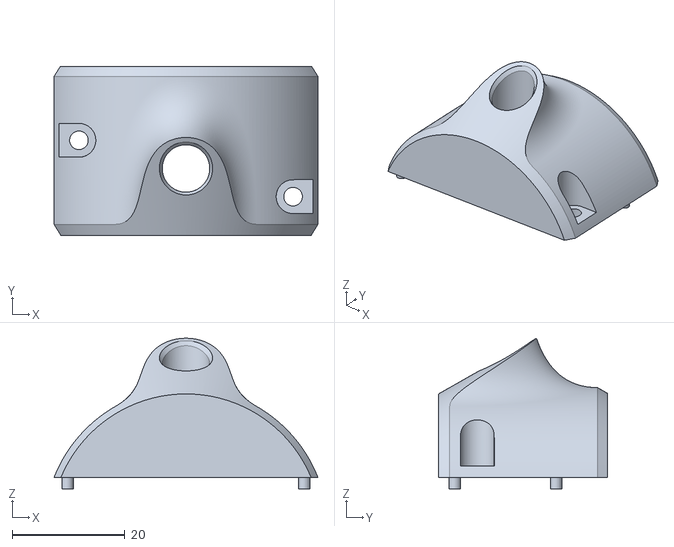
[picture p51: CAD file, 2018-07-25]
3Dmodel/STL/2colors/main/R-W-08.stl
46.8 x 30.0 x 26.7
