araujoB105/BWRCprostheticArm/3Dmodel/STL/Left/Hand/L-H-06.stl

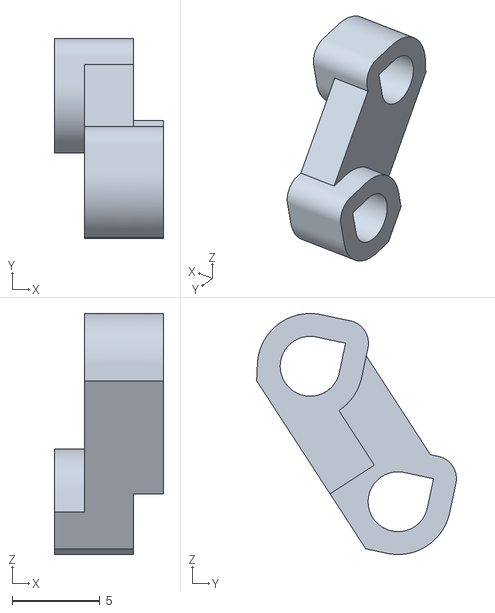
[picture p52: CAD file, 2018-07-25]
3Dmodel/STL/Left/Hand/L-H-06.stl
6.20 x 11.4 x 13.7
