araujoB105/BWRCprostheticArm/3Dmodel/STL/Left/Otherfingers/L-O-05.stl

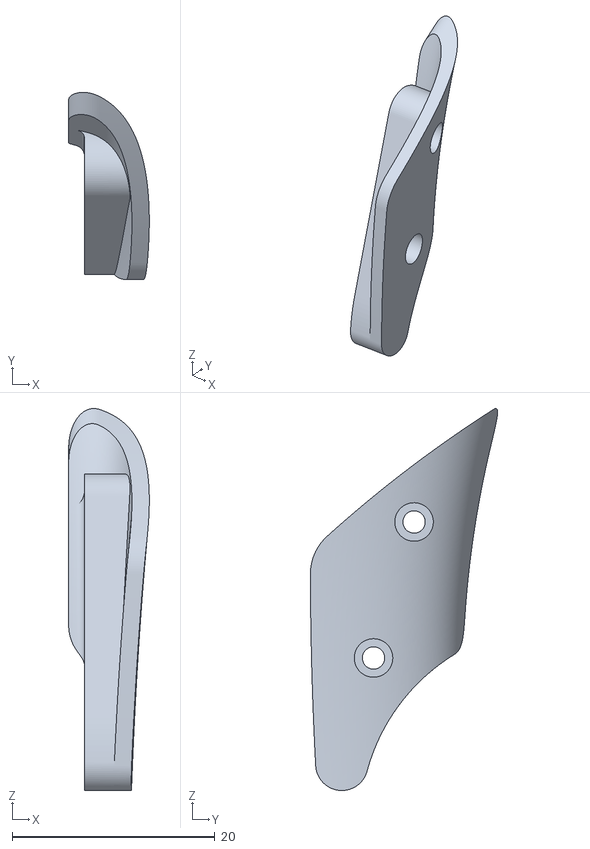
[picture p53: CAD file, 2018-07-25]
3Dmodel/STL/Left/Otherfingers/L-O-05.stl
7.95 x 18.5 x 37.7
