araujoB105/BWRCprostheticArm/3Dmodel/STL/Left/Socket/L-SO-01.stl

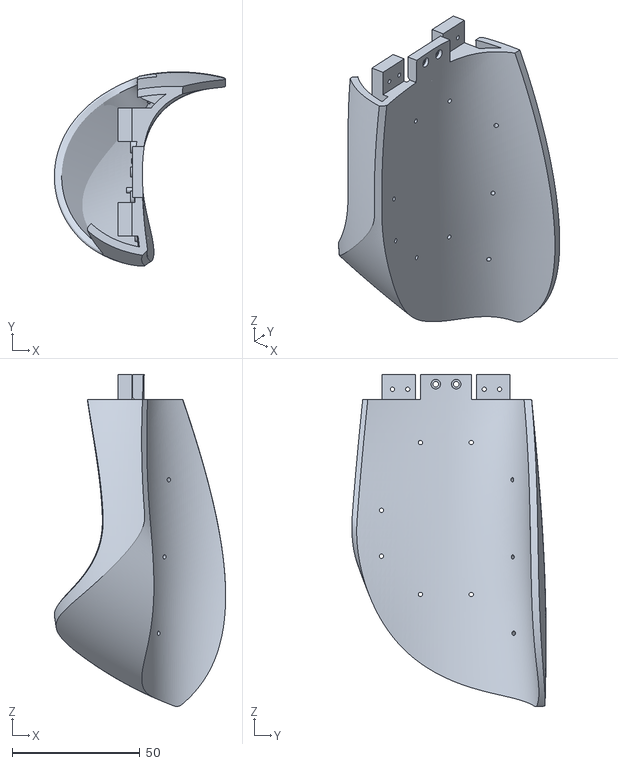
[picture p54: CAD file, 2018-07-25]
3Dmodel/STL/Left/Socket/L-SO-01.stl
67.1 x 76.1 x 130.1
