araujoB105/BWRCprostheticArm/3Dmodel/STL/Left/Wrist/L-W-03.stl

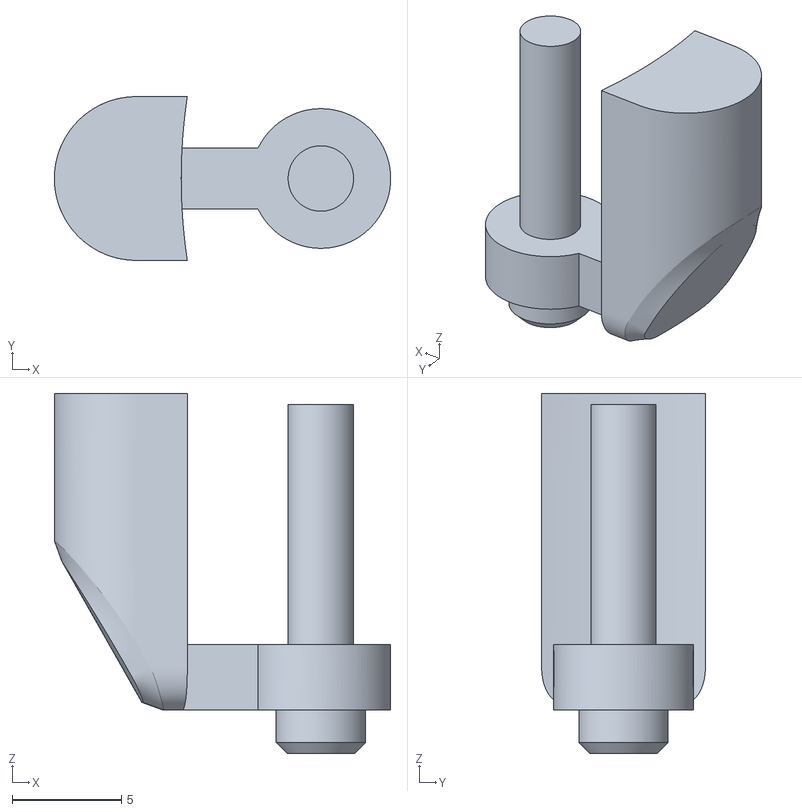
[picture p55: CAD file, 2018-07-25]
3Dmodel/STL/Left/Wrist/L-W-03.stl
15.4 x 7.50 x 16.5
