araujoB105/BWRCprostheticArm/3Dmodel/STL/palmDiffColor/HbBackCoverB_STL.stl

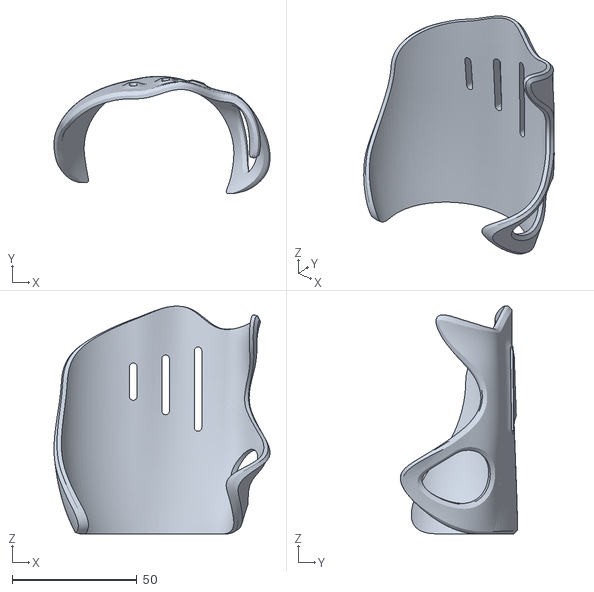
[picture p56: CAD file, 2018-07-25]
3Dmodel/STL/palmDiffColor/HbBackCoverB_STL.stl
86.7 x 47.1 x 91.4
