araujoB105/BWRCprostheticArm/3Dmodel/STL/Right/Thumbfinger/R-T-02.stl

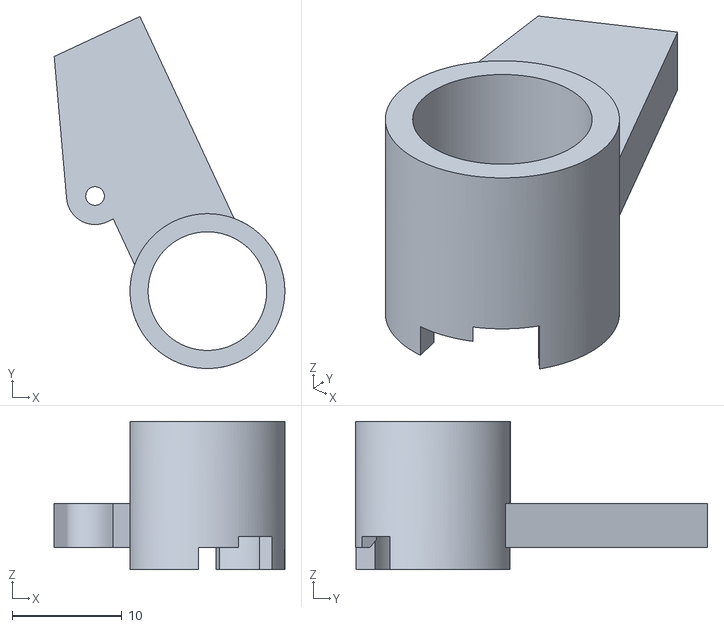
[picture p57: CAD file, 2018-07-25]
3Dmodel/STL/Right/Thumbfinger/R-T-02.stl
21.0 x 32.1 x 13.5
