araujoB105/BWRCprostheticArm/3Dmodel/STL/Left/Indexfinger/L-I-03.stl

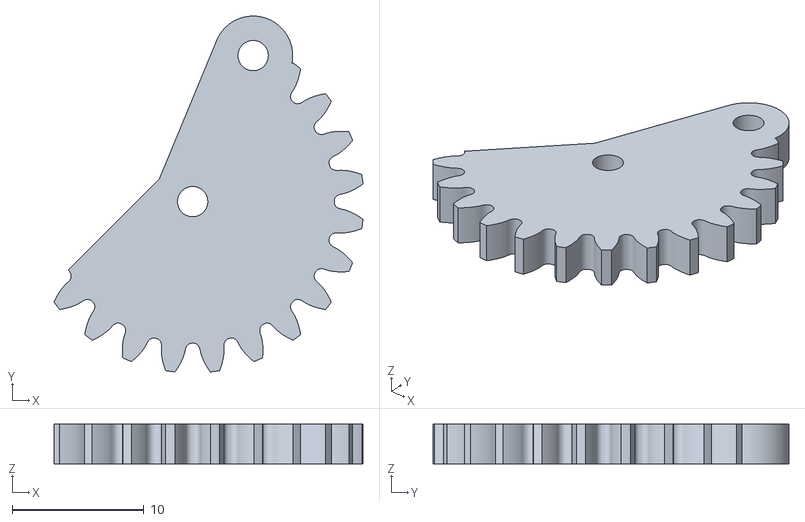
[picture p58: CAD file, 2018-07-25]
3Dmodel/STL/Left/Indexfinger/L-I-03.stl
23.5 x 27.0 x 3.00
