araujoB105/BWRCprostheticArm/3Dmodel/STL/Left/Otherfingers/L-O-01.stl

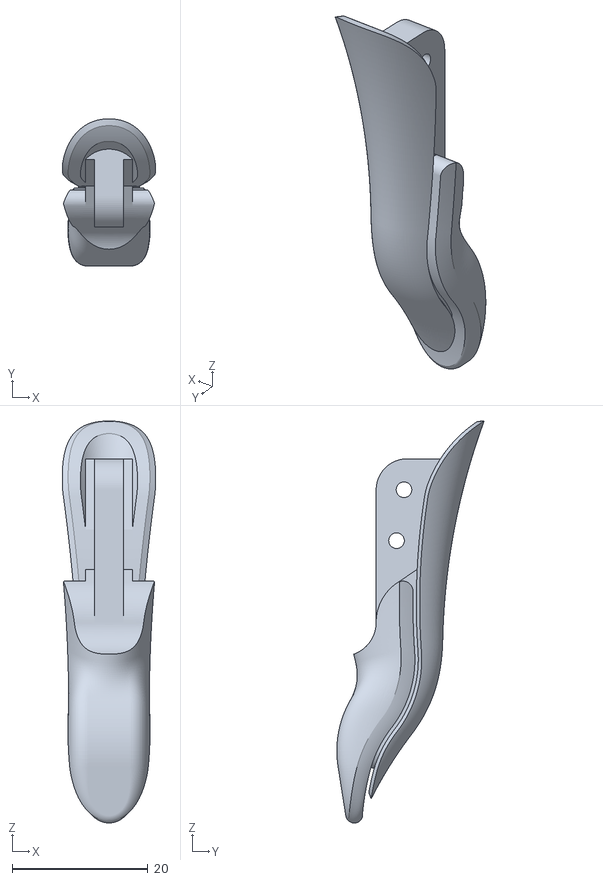
[picture p59: CAD file, 2018-07-25]
3Dmodel/STL/Left/Otherfingers/L-O-01.stl
13.8 x 21.7 x 59.2
