araujoB105/BWRCprostheticArm/3Dmodel/STL/Left/Socket/L-SO-06.stl

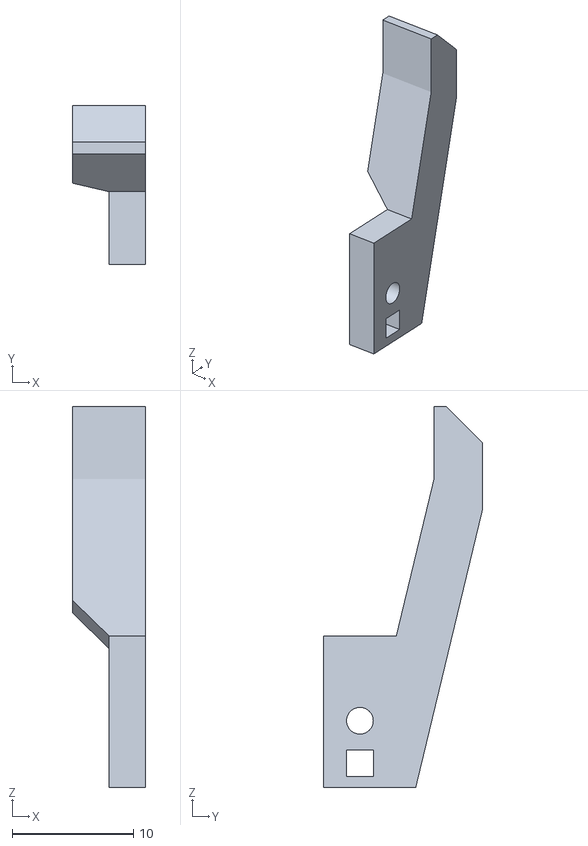
[picture p60: CAD file, 2018-07-25]
3Dmodel/STL/Left/Socket/L-SO-06.stl
6.00 x 13.1 x 31.4
