araujoB105/BWRCprostheticArm/3Dmodel/STL/Left/Thumbfinger/L-T-04.stl

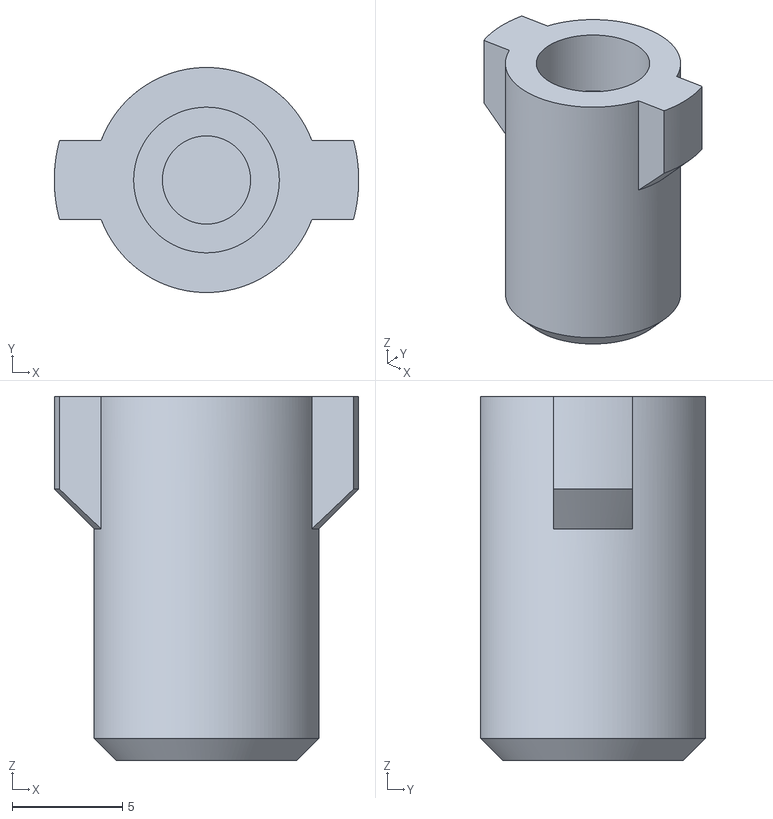
[picture p61: CAD file, 2018-07-25]
3Dmodel/STL/Left/Thumbfinger/L-T-04.stl
13.8 x 10.2 x 16.5
