araujoB105/BWRCprostheticArm/3Dmodel/STL/palmDiffColor/HbPalmBaseB_STL.stl

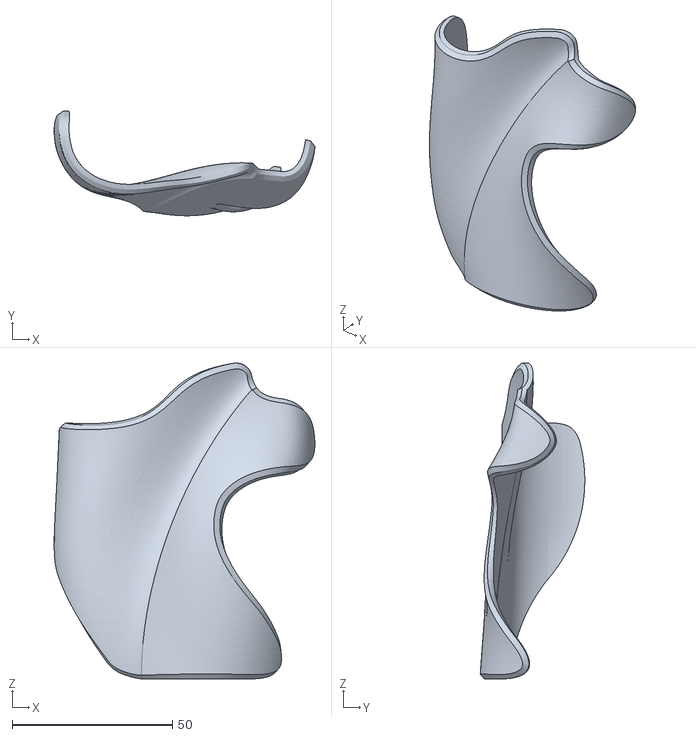
[picture p62: CAD file, 2018-07-25]
3Dmodel/STL/palmDiffColor/HbPalmBaseB_STL.stl
81.3 x 32.6 x 98.5
