araujoB105/BWRCprostheticArm/3Dmodel/STL/Right/Socket/R-SO-08.stl

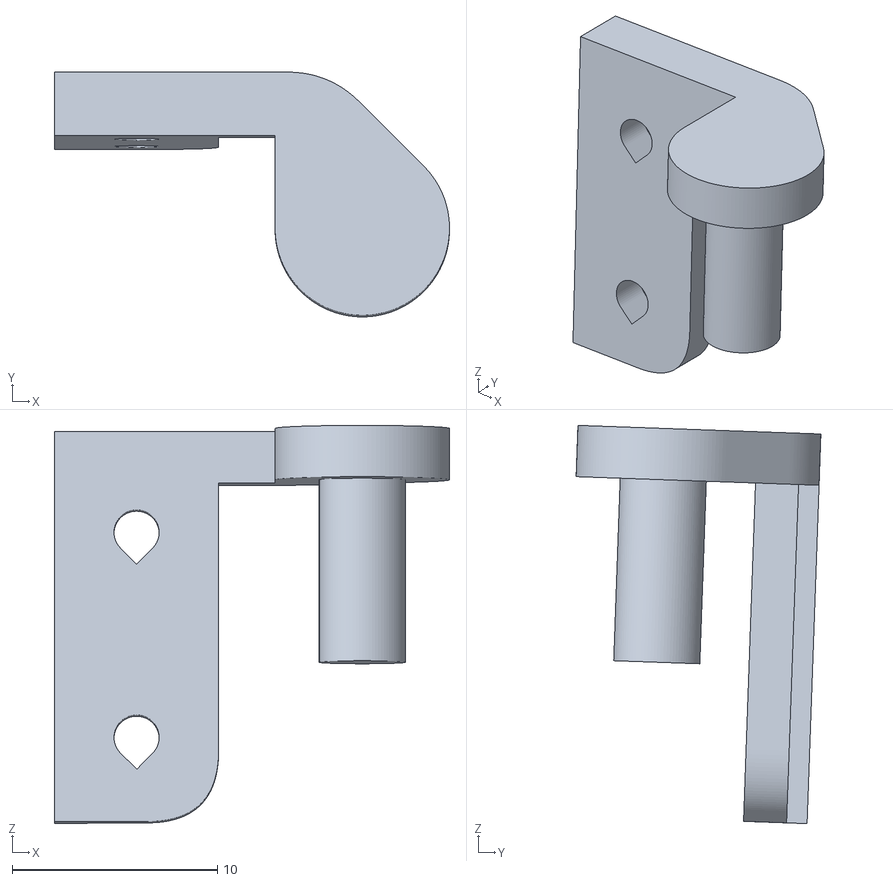
[picture p63: CAD file, 2018-07-25]
3Dmodel/STL/Right/Socket/R-SO-08.stl
19.2 x 11.9 x 19.4
