araujoB105/BWRCprostheticArm/3Dmodel/STL/Right/Wrist/R-W-01.stl

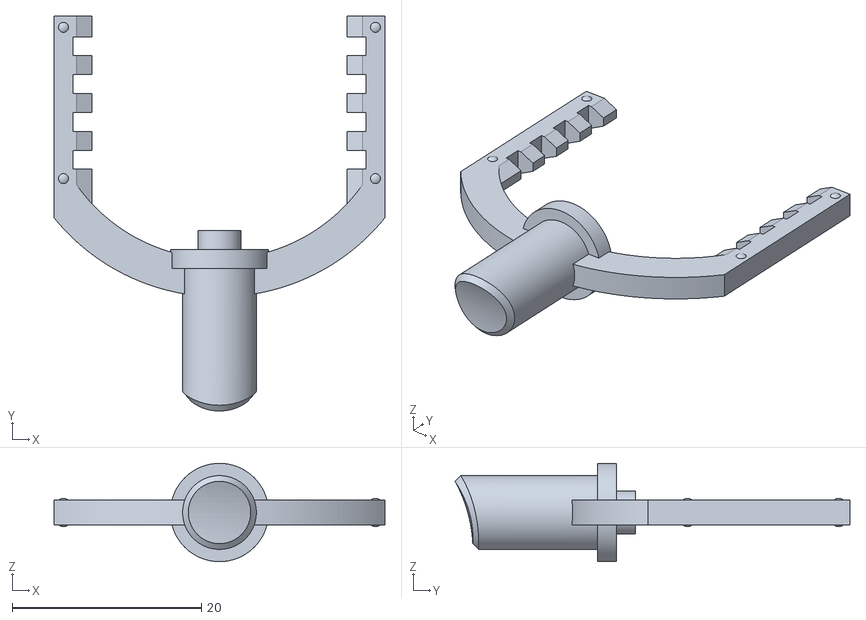
[picture p64: CAD file, 2018-07-25]
3Dmodel/STL/Right/Wrist/R-W-01.stl
35.0 x 41.8 x 10.4
