araujoB105/BWRCprostheticArm/3Dmodel/STL/Left/Hand/L-H-10.stl

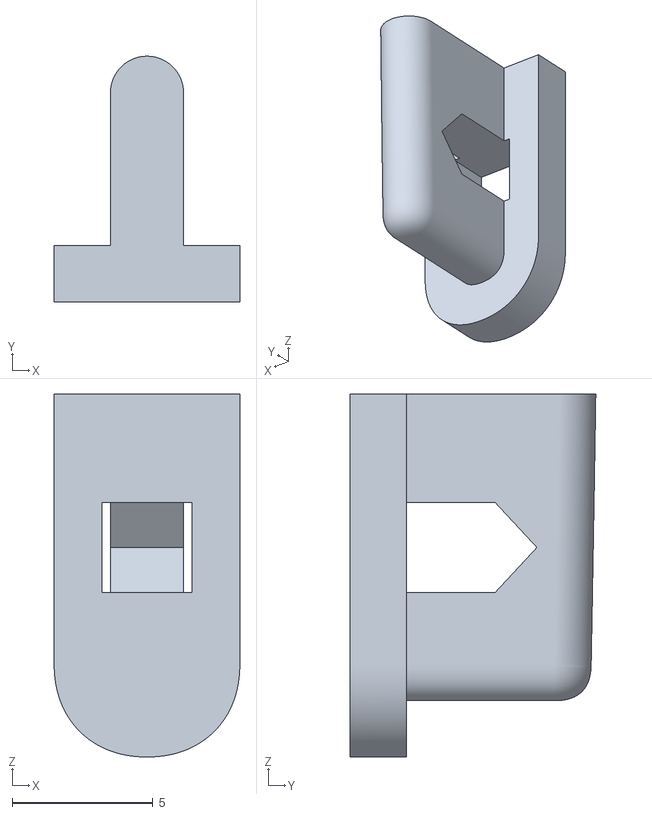
[picture p65: CAD file, 2018-07-25]
3Dmodel/STL/Left/Hand/L-H-10.stl
6.60 x 8.73 x 12.9
