araujoB105/BWRCprostheticArm/3Dmodel/STL/Left/Indexfinger/L-I-01.stl

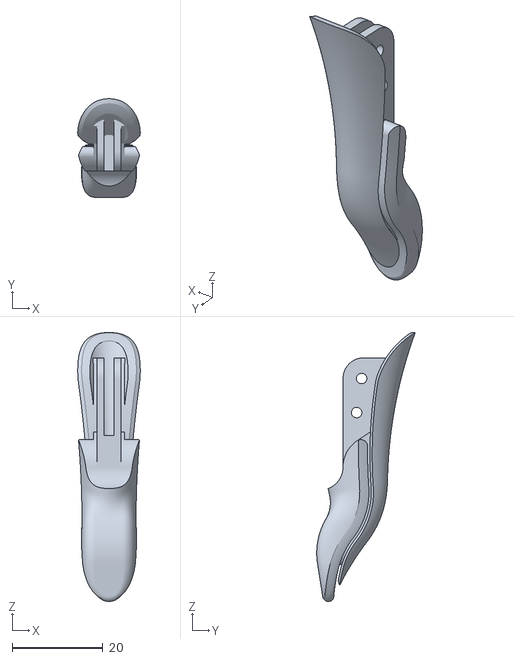
[picture p66: CAD file, 2018-07-25]
3Dmodel/STL/Left/Indexfinger/L-I-01.stl
13.8 x 21.7 x 59.2
