araujoB105/BWRCprostheticArm/3Dmodel/STL/Left/Socket/L-SO-07.stl

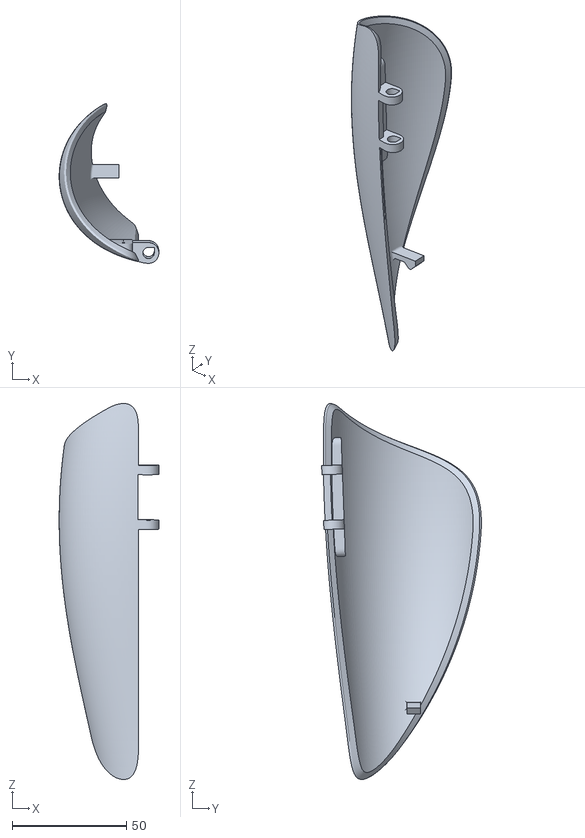
[picture p67: CAD file, 2018-07-25]
3Dmodel/STL/Left/Socket/L-SO-07.stl
43.6 x 70.0 x 164.6
