araujoB105/BWRCprostheticArm/3Dmodel/STL/Left/Wrist/L-W-06.stl

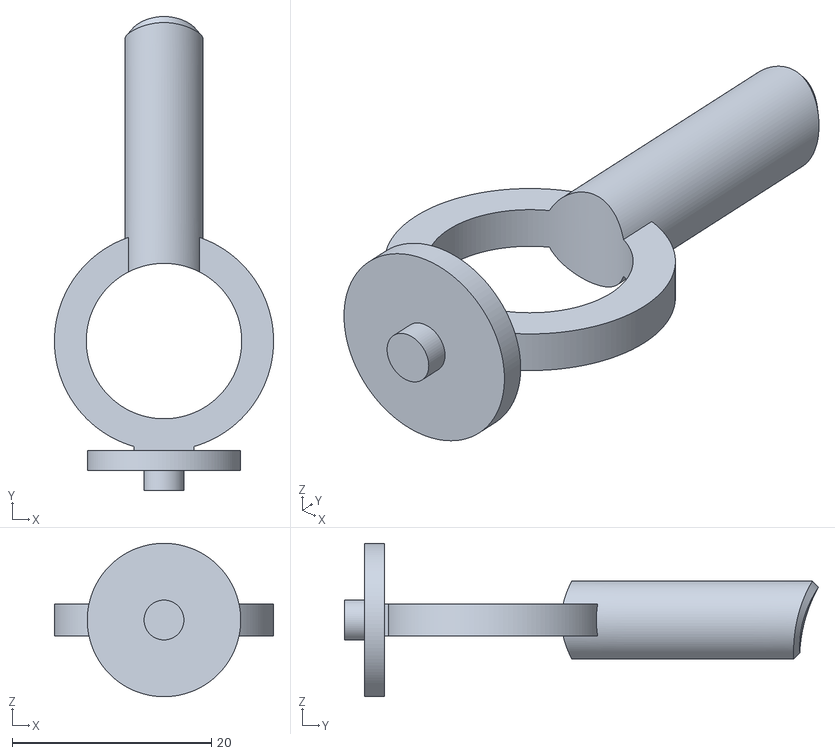
[picture p68: CAD file, 2018-07-25]
3Dmodel/STL/Left/Wrist/L-W-06.stl
22.0 x 47.6 x 15.4
