araujoB105/BWRCprostheticArm/3Dmodel/STL/Right/Indexfinger/R-I-06.stl

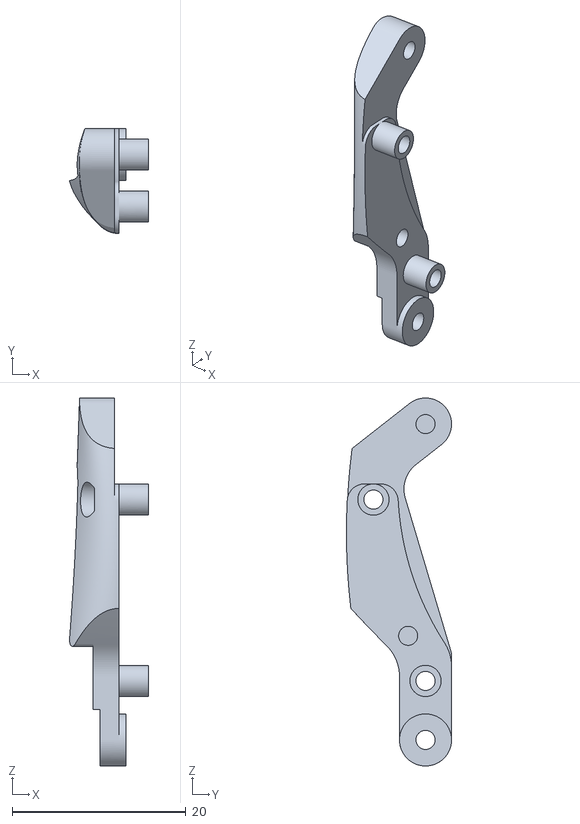
[picture p69: CAD file, 2018-07-25]
3Dmodel/STL/Right/Indexfinger/R-I-06.stl
9.09 x 12.1 x 42.4
