araujoB105/BWRCprostheticArm/3Dmodel/STL/Right/Wrist/R-W-07.stl

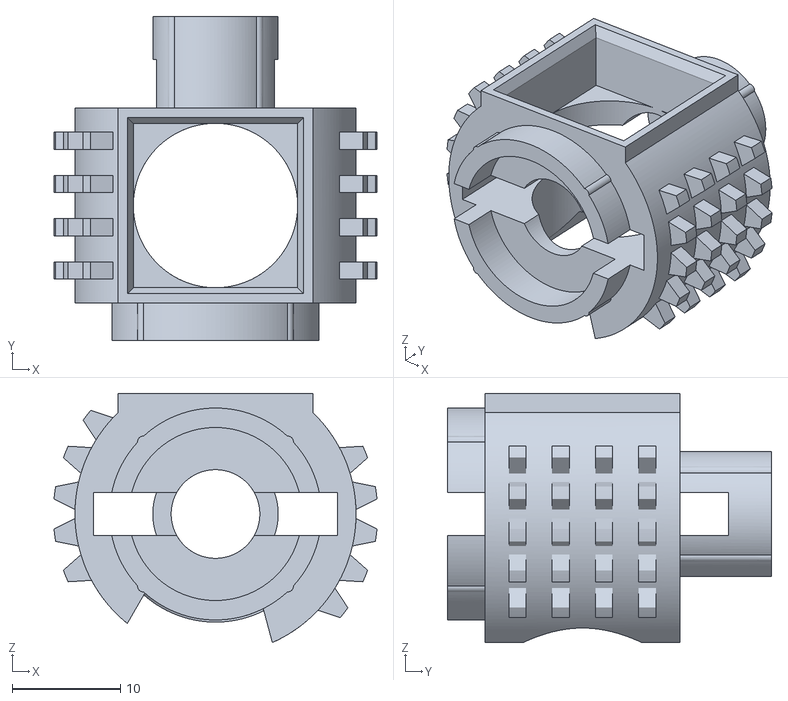
[picture p70: CAD file, 2018-07-25]
3Dmodel/STL/Right/Wrist/R-W-07.stl
29.9 x 30.0 x 23.0
