araujoB105/BWRCprostheticArm/3Dmodel/STL/Left/Hand/L-H-04.stl

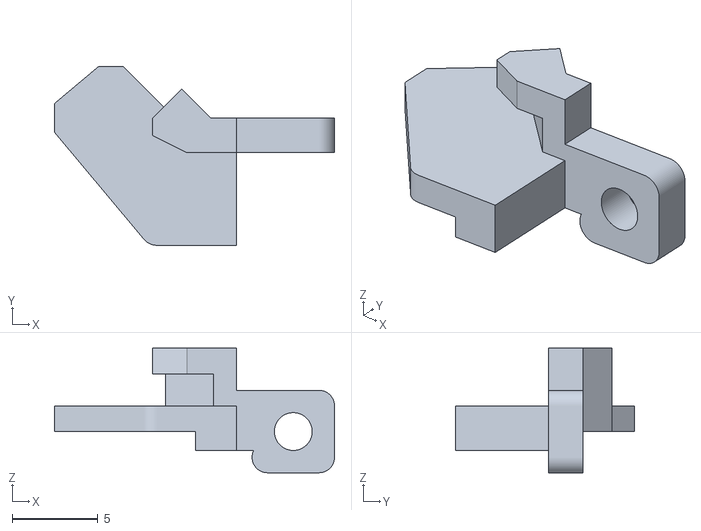
[picture p71: CAD file, 2018-07-25]
3Dmodel/STL/Left/Hand/L-H-04.stl
16.3 x 10.4 x 7.25
