araujoB105/BWRCprostheticArm/3Dmodel/STL/Left/Hand/L-H-14.stl

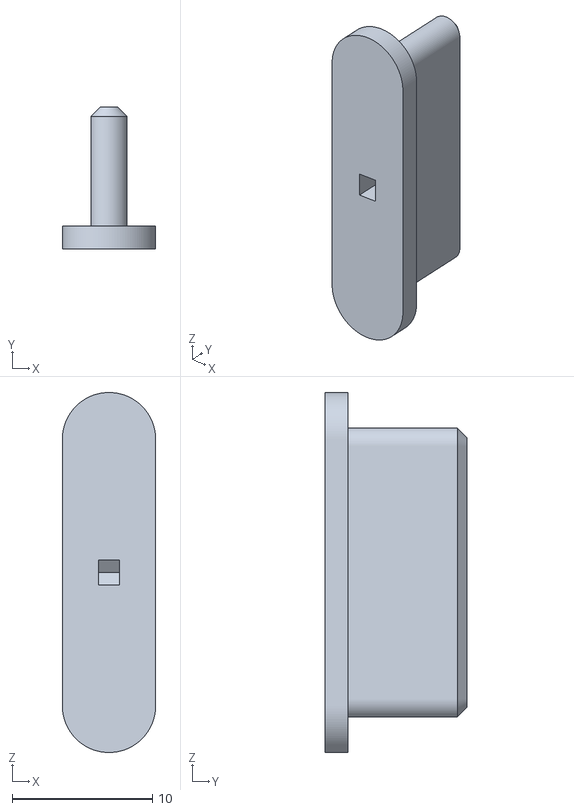
[picture p72: CAD file, 2018-07-25]
3Dmodel/STL/Left/Hand/L-H-14.stl
6.65 x 10.1 x 25.6
