araujoB105/BWRCprostheticArm/3Dmodel/STL/Left/Socket/L-SO-02.stl

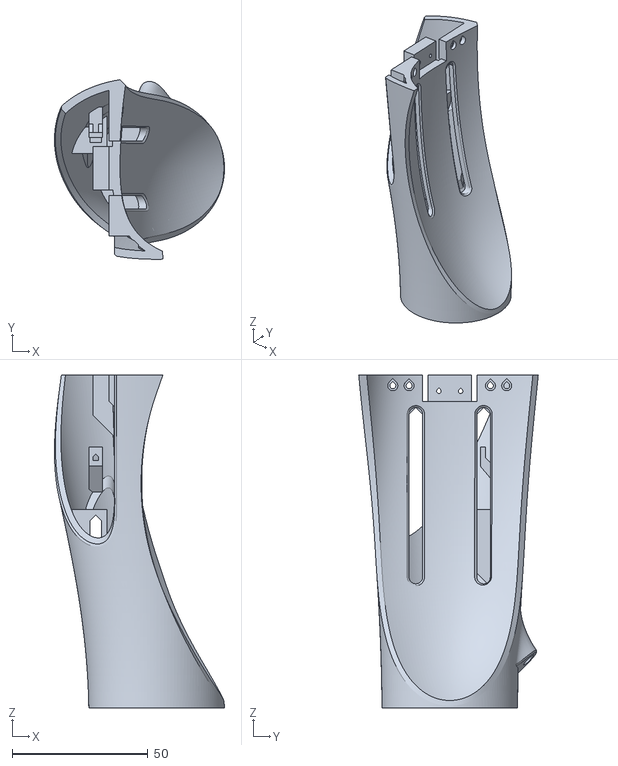
[picture p73: CAD file, 2018-07-25]
3Dmodel/STL/Left/Socket/L-SO-02.stl
62.7 x 66.2 x 122.8
