araujoB105/BWRCprostheticArm/3Dmodel/STL/Right/Hand/R-H-09.stl

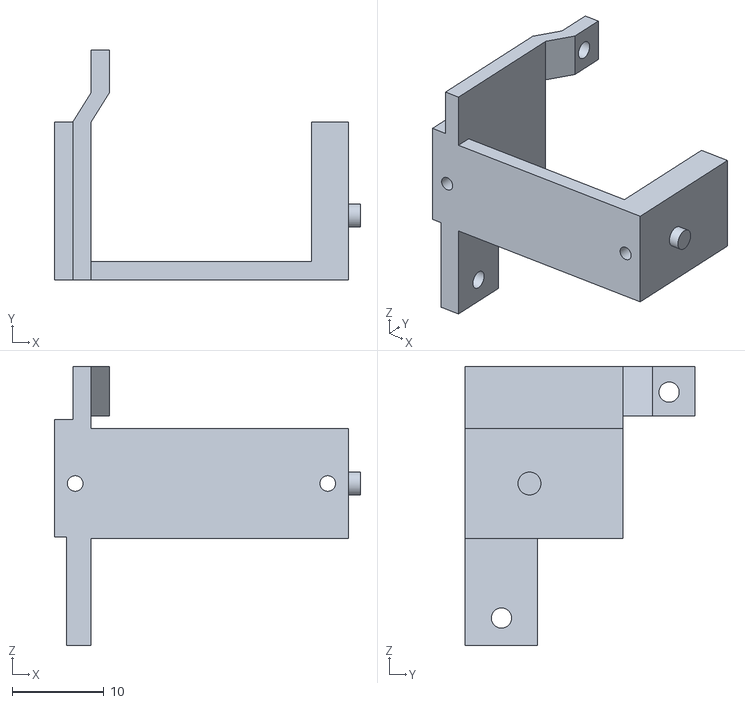
[picture p74: CAD file, 2018-07-25]
3Dmodel/STL/Right/Hand/R-H-09.stl
33.3 x 25.0 x 30.4
