araujoB105/BWRCprostheticArm/3Dmodel/STL/Left/Hand/L-H-02.stl

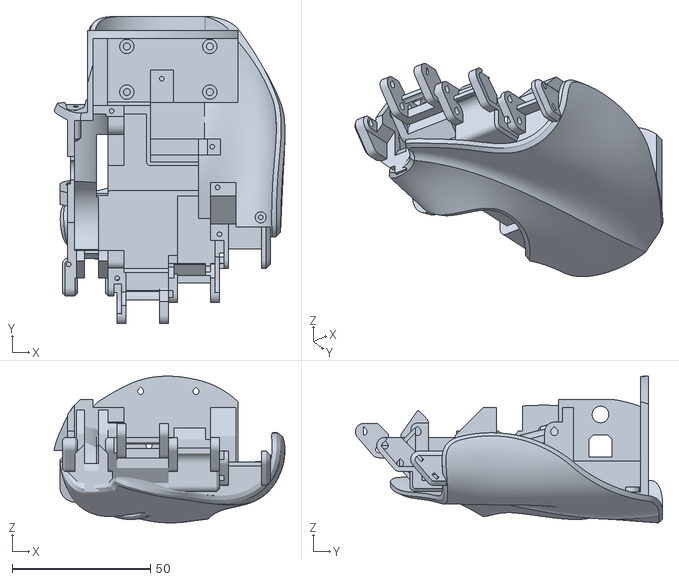
[picture p75: CAD file, 2018-07-25]
3Dmodel/STL/Left/Hand/L-H-02.stl
83.5 x 111.1 x 53.1
