araujoB105/BWRCprostheticArm/3Dmodel/STL/Left/Hand/L-H-05.stl

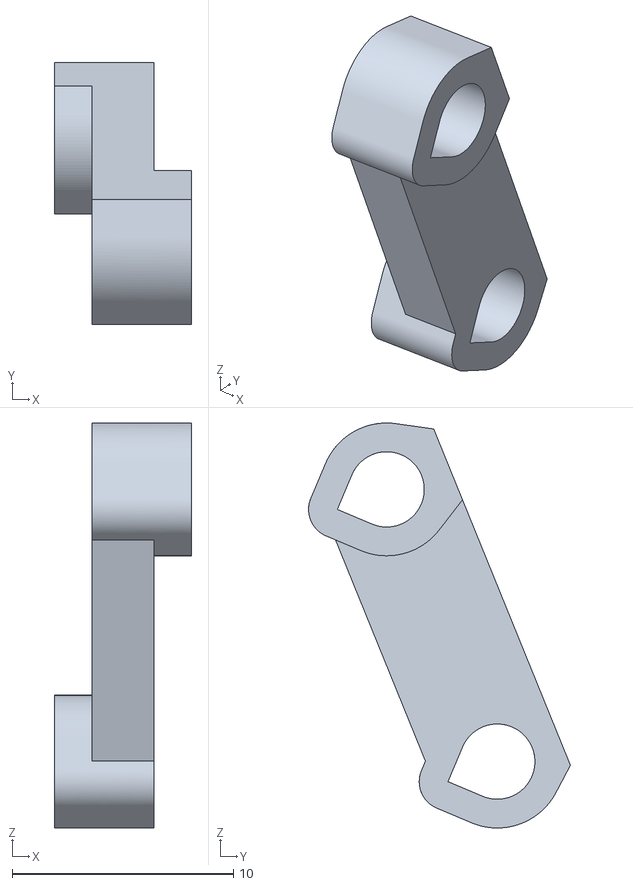
[picture p76: CAD file, 2018-07-25]
3Dmodel/STL/Left/Hand/L-H-05.stl
6.20 x 11.8 x 18.3
