araujoB105/BWRCprostheticArm/3Dmodel/STL/Right/Hand/R-H-03.stl

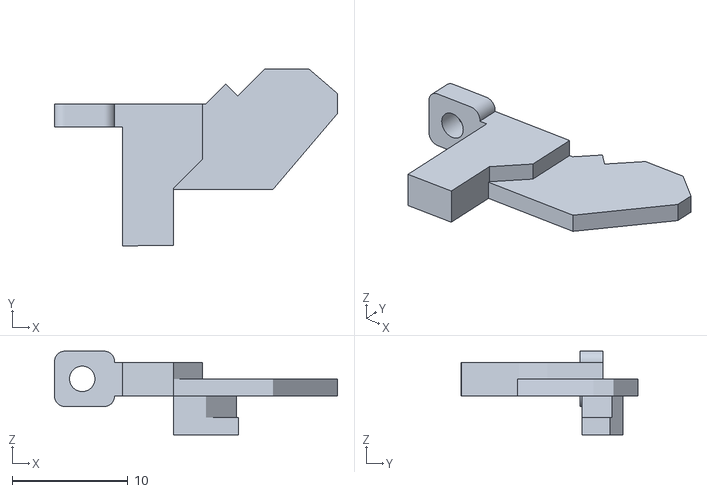
[picture p77: CAD file, 2018-07-25]
3Dmodel/STL/Right/Hand/R-H-03.stl
24.5 x 15.3 x 7.25
