araujoB105/BWRCprostheticArm/(list of files, cad)

Other CAD files:
3Dmodel/STL/Right/Otherfingers/R-O-04.stl
3Dmodel/STL/Right/Wrist/R-W-04.stl
3Dmodel/STL/2colors/main/R-T-03.stl
3Dmodel/STL/Left/Socket/L-SO-03.stl
3Dmodel/STL/Left/Indexfinger/L-I-05.stl
3Dmodel/STL/Left/Thumbfinger/L-T-05.stl
3Dmodel/STL/Right/Indexfinger/R-I-07.stl
3Dmodel/STL/Right/Otherfingers/R-O-05.stl
3Dmodel/STL/Right/Socket/R-SO-01.stl
3Dmodel/STL/Right/Wrist/R-W-03.stl
3Dmodel/STL/Left/Hand/L-H-07.stl
3Dmodel/STL/Left/Wrist/L-W-08.stl
3Dmodel/STL/Right/Hand/R-H-01.stl
3Dmodel/STL/Right/Indexfinger/R-I-03.stl
3Dmodel/STL/Right/Otherfingers/R-O-01.stl
3Dmodel/STL/Right/Thumbfinger/R-T-04.stl
3Dmodel/STL/2colors/secondary/R-O-04.stl
3Dmodel/STL/Left/Otherfingers/L-O-03.stl
3Dmodel/STL/Left/Thumbfinger/L-T-01.stl
3Dmodel/STL/Right/Otherfingers/R-O-02.stl
3Dmodel/STL/Right/Thumbfinger/R-T-03.stl
3Dmodel/STL/2colors/main/R-I-02.stl
3Dmodel/STL/Left/Indexfinger/L-I-04.stl
3Dmodel/STL/Left/Socket/L-SO-05.stl
3Dmodel/STL/Left/Thumbfinger/L-T-02.stl
3Dmodel/STL/Left/Wrist/L-W-02.stl
3Dmodel/STL/Right/Hand/R-H-06.stl
3Dmodel/STL/Right/Indexfinger/R-I-02.stl
3Dmodel/STL/Right/Socket/R-SO-06.stl
3Dmodel/STL/Right/Thumbfinger/R-T-06.stl
3Dmodel/STL/Right/Wrist/R-W-06.stl
3Dmodel/STL/2colors/secondary/R-H-01.stl
3Dmodel/STL/Left/Hand/L-H-12.stl
3Dmodel/STL/Left/Indexfinger/L-I-07.stl
3Dmodel/STL/Left/Socket/L-SO-08.stl
3Dmodel/STL/Left/Wrist/L-W-01.stl
3Dmodel/STL/Right/Hand/R-H-04.stl
3Dmodel/STL/Right/Indexfinger/R-I-01.stl
3Dmodel/STL/Right/Socket/R-SO-03.stl
3Dmodel/STL/Right/Wrist/R-W-05.stl
3Dmodel/STL/2colors/main/R-T-06.stl
3Dmodel/STL/Left/Socket/L-SO-10.stl
3Dmodel/STL/Left/Wrist/L-W-07.stl
3Dmodel/STL/Right/Hand/R-H-11.stl
3Dmodel/STL/Right/Socket/R-SO-04.stl
3Dmodel/STL/2colors/secondary/R-W-06.stl
3Dmodel/STL/Left/Hand/L-H-08.stl
3Dmodel/STL/Right/Socket/R-SO-02.stl
3Dmodel/STL/2colors/main/R-I-01.stl
3Dmodel/STL/Left/Socket/L-SO-09.stl
3Dmodel/STL/Right/Hand/R-H-14.stl
3Dmodel/STL/Right/Socket/R-SO-07.stl
3Dmodel/STL/2colors/main/R-W-04.stl
3Dmodel/STL/2colors/secondary/R-H-14.stl
3Dmodel/STL/2colors/main/R-SO-03done.stl
3Dmodel/STL/Left/Hand/L-H-13.stl
3Dmodel/STL/Right/Hand/R-H-05.stl
3Dmodel/STL/2colors/main/R-O-05.stl
3Dmodel/STL/2colors/secondary/R-H-10.stl
3Dmodel/STL/Left/Hand/L-H-09.stl
3Dmodel/STL/Right/Hand/R-H-10.stl
3Dmodel/STL/2colors/main/R-SO-04done.stl
3Dmodel/STL/2colors/secondary/R-H-04.stl
3Dmodel/STL/Left/Hand/L-H-03.stl
3Dmodel/STL/Right/Hand/R-H-02.stl
3Dmodel/STL/2colors/main/R-SO-02done.stl
3Dmodel/STL/2colors/secondary/R-H-11.stl
3Dmodel/STL/2colors/main/R-W-05.stl
3Dmodel/STL/2colors/secondary/R-I-03.stl
3Dmodel/STL/2colors/main/R-SO-06done.stl
3Dmodel/STL/2colors/main/R-O-01.stl
3Dmodel/STL/2colors/main/R-W-03.stl
3Dmodel/STL/2colors/secondary/R-H-06.stl
3Dmodel/STL/2colors/main/R-SO-01long.stl
3Dmodel/STL/2colors/main/R-O-02.stl
3Dmodel/STL/2colors/secondary/R-H-05.stl
3Dmodel/STL/2colors/secondary/R-I-07.stl
3Dmodel/STL/2colors/secondary/R-SO-07.stl
3Dmodel/STL/2colors/secondary/R-T-04.stl
