araujoB105/BWRCprostheticArm/hardware/mountingGuideArm.pdf

# Prosthetic Arm How-to

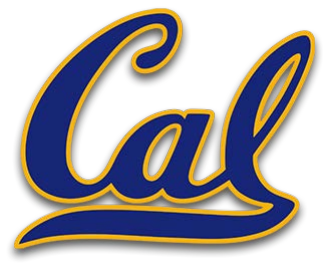
[picture p78: figure]
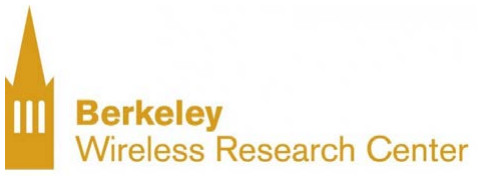
[picture p79: figure]

Alvaro Araujo
July, 2018

## Mount -wrist

- First of all, screw the wirst on the palm base because once the elements are assembled on the hand (fingers, components), it becomes impossible to do it.

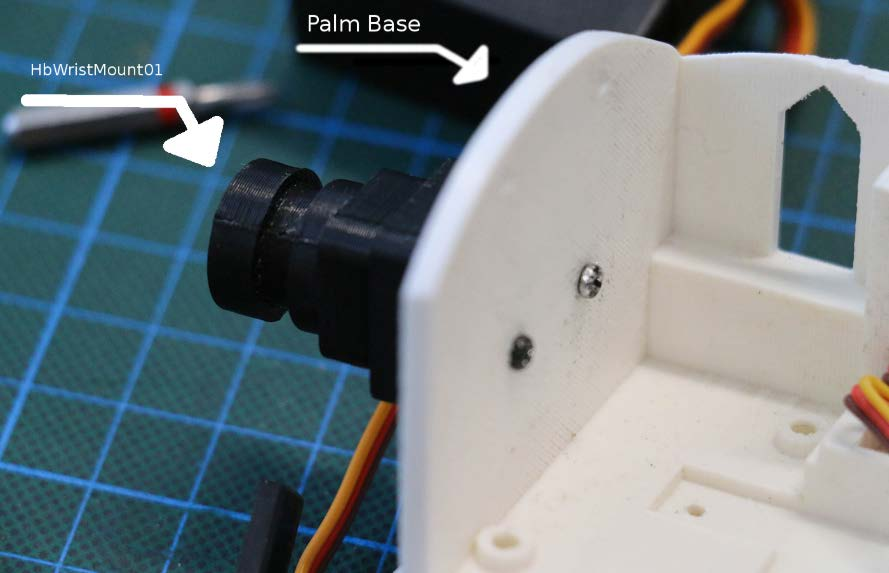
[picture p80: figure]

24/07/2018 | Alvaro Araujo | 2

## Mount - Middle finger assembly set

- Adjust the holes that will receive the pins with 1.8mm drill (up to 1.9mm)
- Insert axes
- Put together the components as shown from left to right, reading from top to bottom
- Tighten all the components with screws

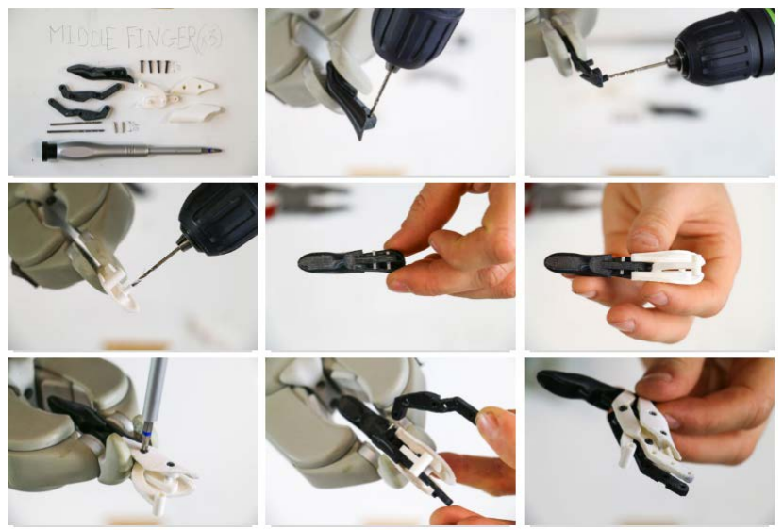
[picture p81: figure]

## Mount - Index assembly instruction set

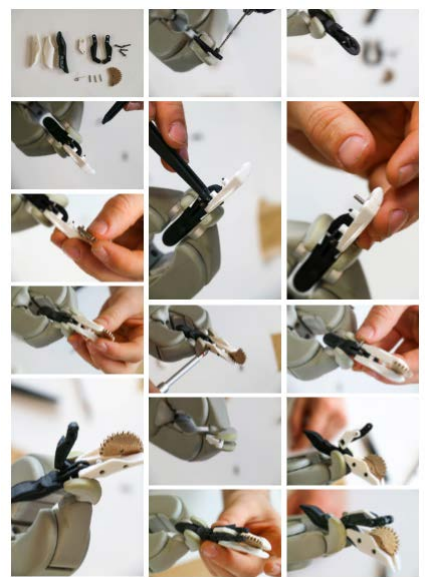
[picture p82: figure]

- Enlarge holes with 1.8mm drill (up to 1.9mm max)
- Insert the pin with the spring
- Assemble elements step by step

## Mount - Installation of 4 fingers on the palm

- Adjust axes of the palm with 1.8mm drill, adjust to 1.9 max if the axe does not fit
- Place little & ring finger with 2 axes for each fingers
- Adjust, insert & screw HbShaftStopperB04 to secure the 2 fingers
- Place the middle finger with his 2 axes
- Place index finger with his 2 axes
- Insert and screw HbShaftStopperA04

## Mount - Installation of 4 fingers on the palm

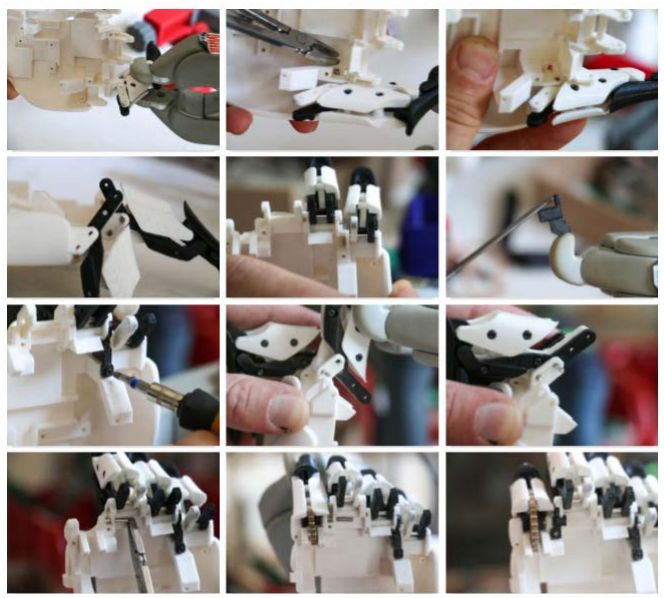
[picture p83: figure]

## Mount - Thumb assembly instruction set

- Check all components and prepare material (3 screws + spring)
- Follow the steps indicated on the pictures, left to right, top to bottom
- Assemble the elements with the ScrewM2L10
- Screw the servo ES08MD on the thumb

## Mount - Thumb assembly instruction set

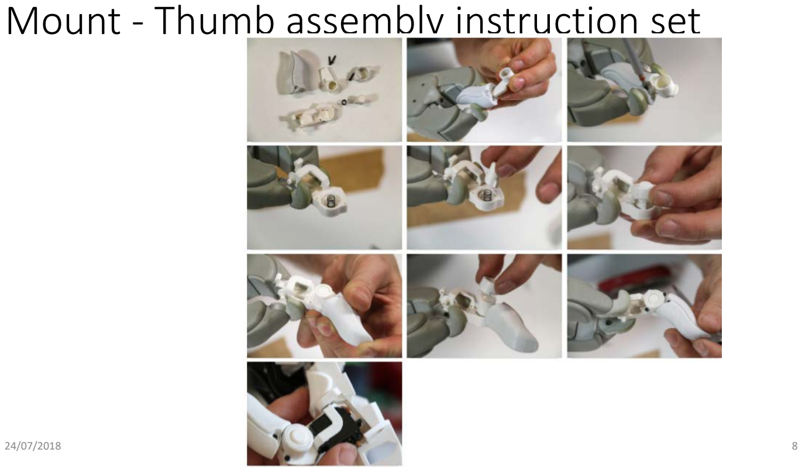
[picture p84: page 8]

## Mount - Set the thumb on the palm

- Insert the mini ball-bearing in the palm as indicated on picture 2
- Place and screw 1 servo ES08MAII in the thumb
- Insert servo's axis in the mini ball-bearing
- Follow the instructions as indicated using 2 screws
- Make sure to fold the cable as indicated, the index motor will be placed above

## Mount - Set the thumb on the palm

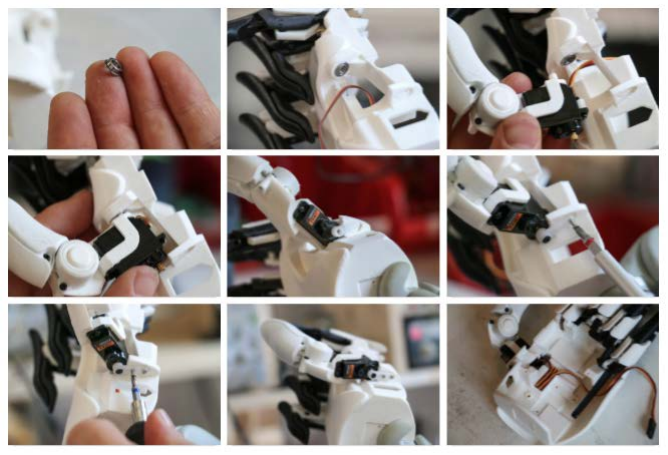
[picture p85: figure]

## Mount - Index's motor assembly set up

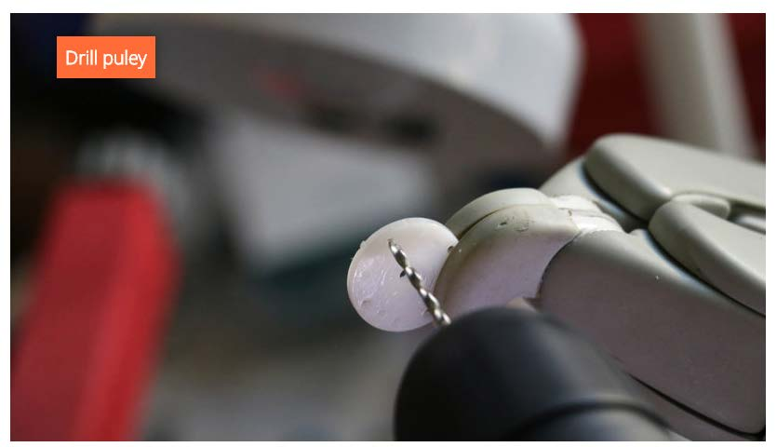
[picture p86: figure]

## Mount - Index's motor assembly set up

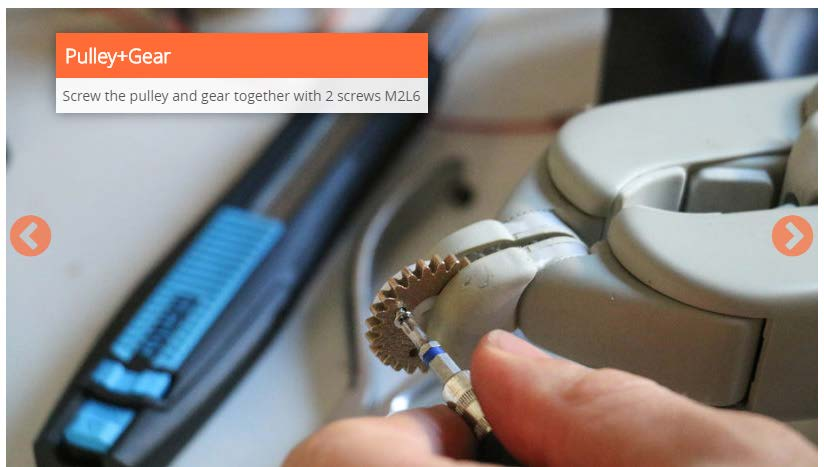
[picture p87: figure]

## Mount - Index's motor assembly set up

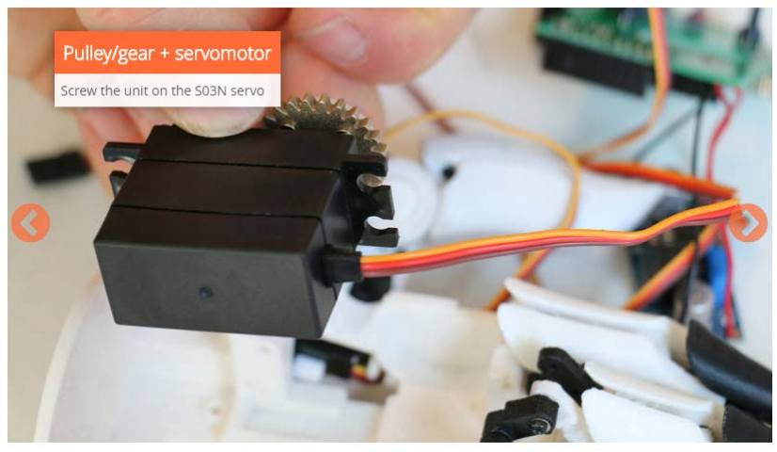
[picture p88: figure]

## Mount - Index's motor assembly set up

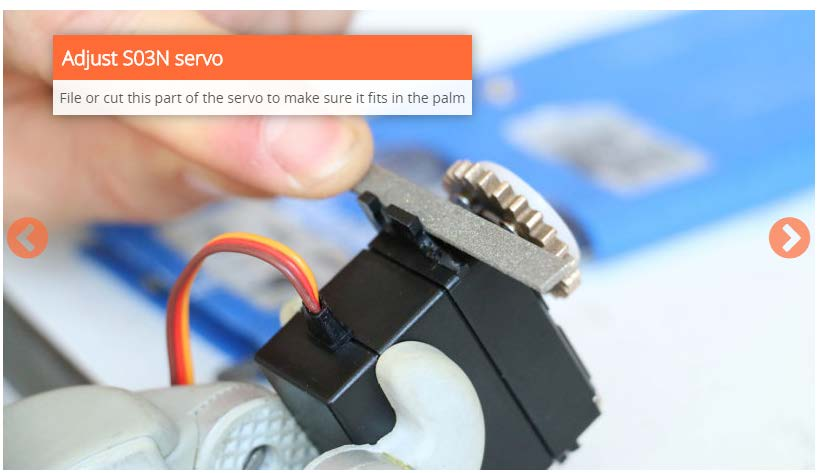
[picture p89: figure]

## Mount - Index's motor assembly set up

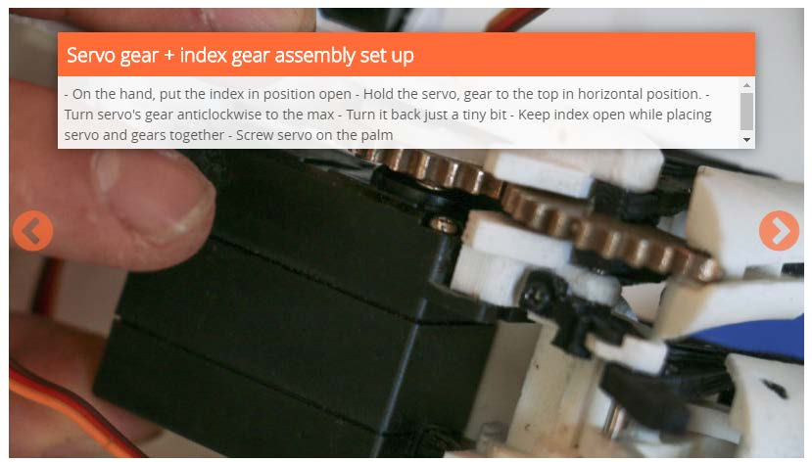
[picture p90: figure]

## Mount - Coupling 3 fingers + servomotor

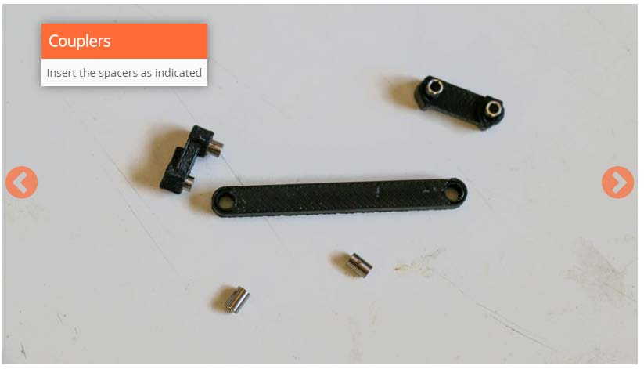
[picture p91: figure]

## Mount - Coupling 3 fingers + servomotor

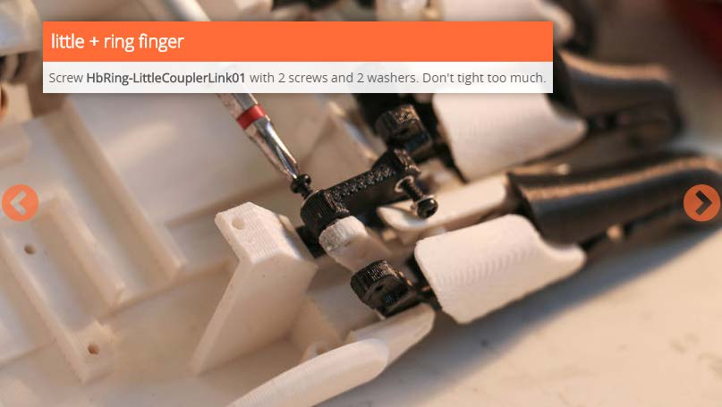
[picture p92: figure]

## Mount - Coupling 3 fingers + servomotor

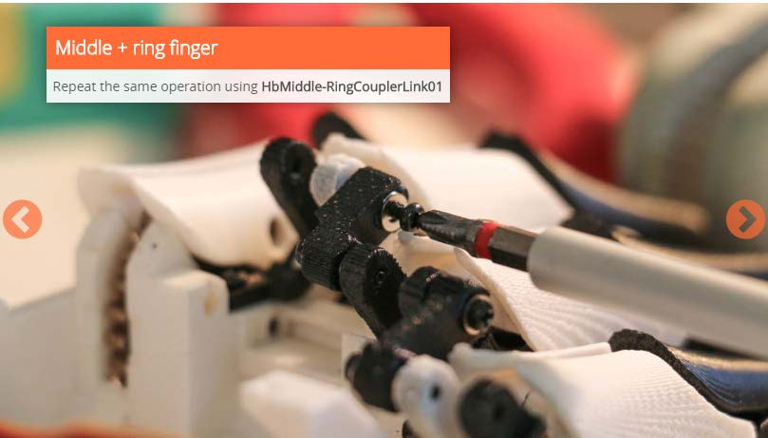
[picture p93: figure]

## Mount - Coupling 3 fingers + servomotor

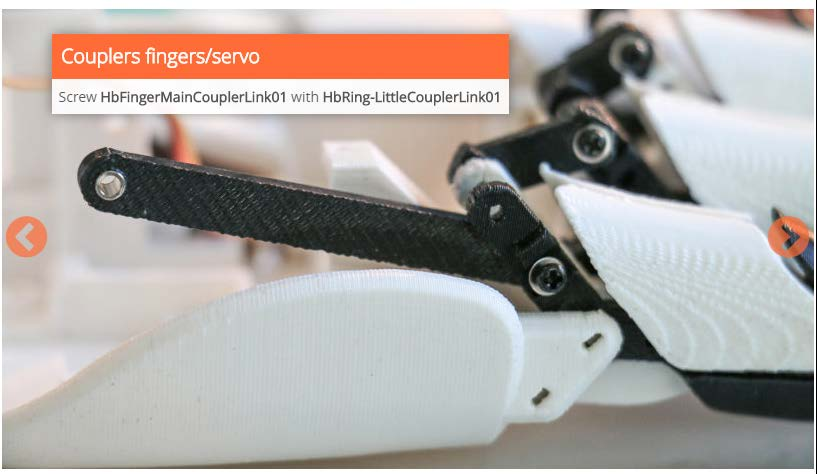
[picture p94: figure]

## Mount - Coupling 3 fingers + servomotor

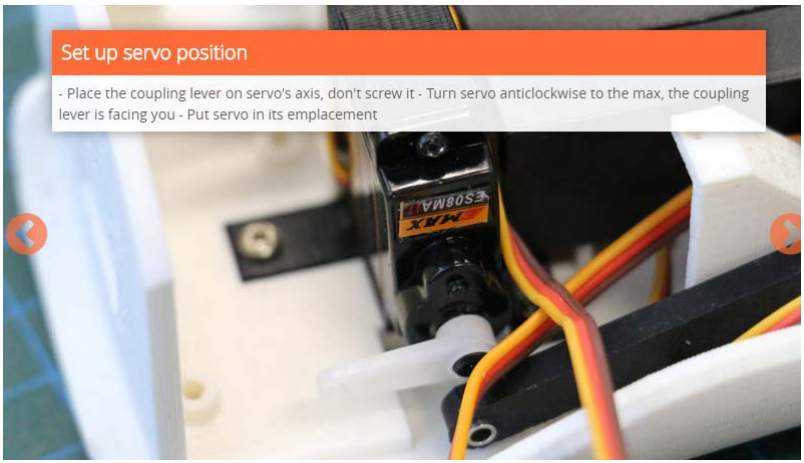
[picture p95: figure]

## Mount - Coupling 3 fingers + servomotor

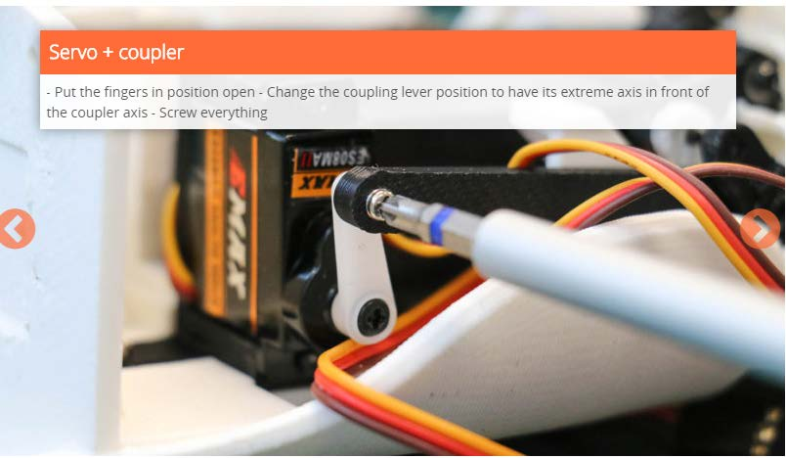
[picture p96: figure]

## Mount – Soldering electronics

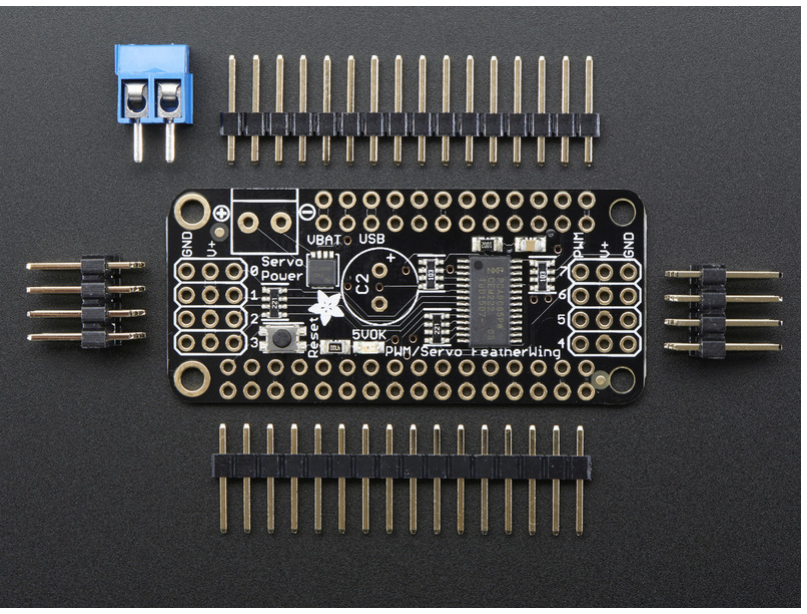
[picture p97: figure]
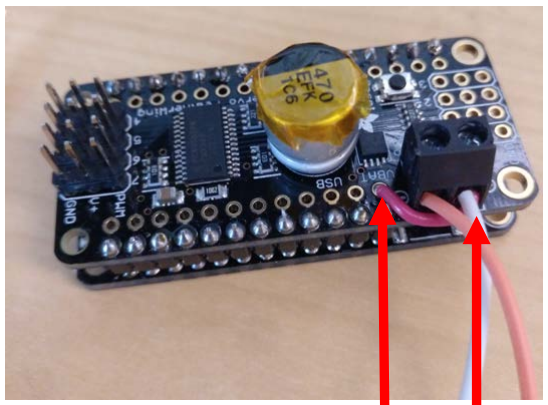
[picture p98: figure]

## Mount – Voltage regulator adjustment

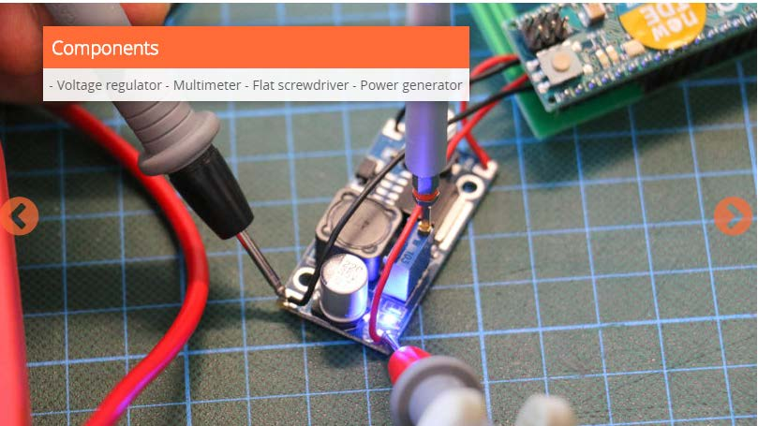
[picture p99: figure]

## Mount – Voltage regulator adjustment

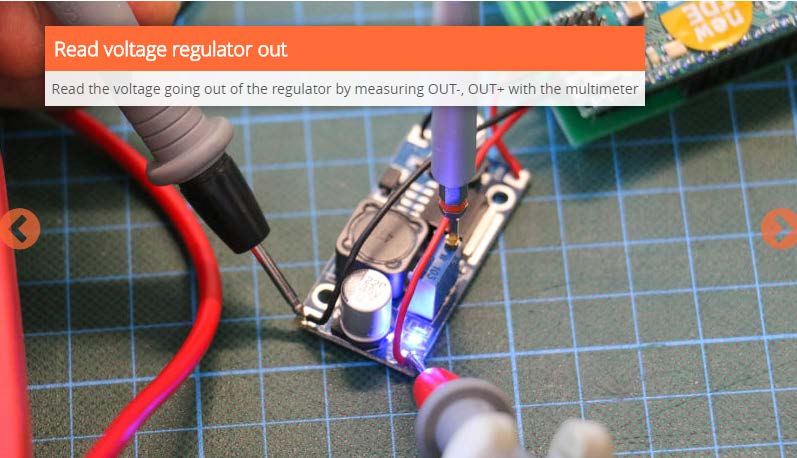
[picture p100: figure]

## Mount – Voltage regulator adjustment

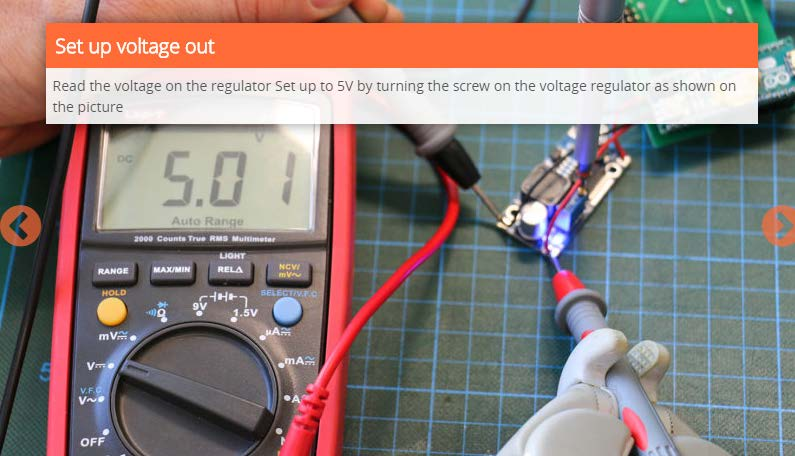
[picture p101: figure]

## Mount – Wirst & socket assembly set up

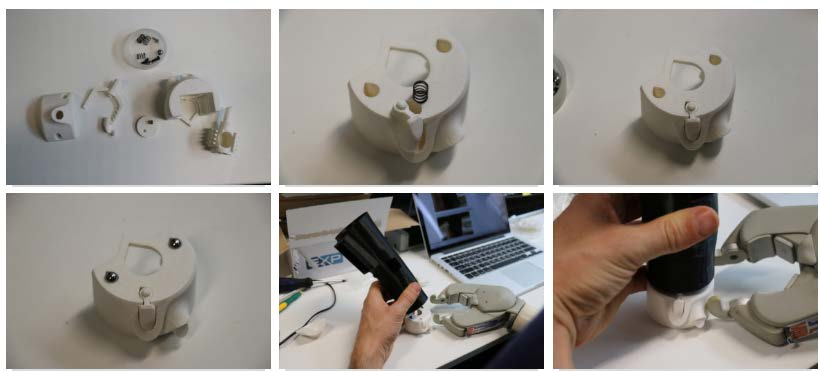
[picture p102: figure]

## Mount – Wirst & socket assembly set up

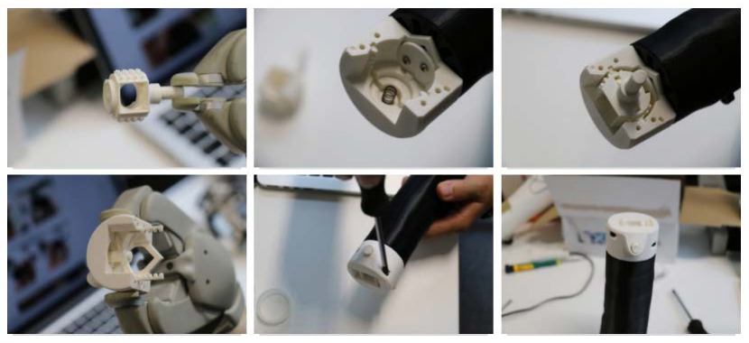
[picture p103: figure]

## Mount – Solder battery cable

- Solder the cable as shown
- check + and - between cable and battery
- Screw the battery holder on the socket
- Put the battery on the battery holder

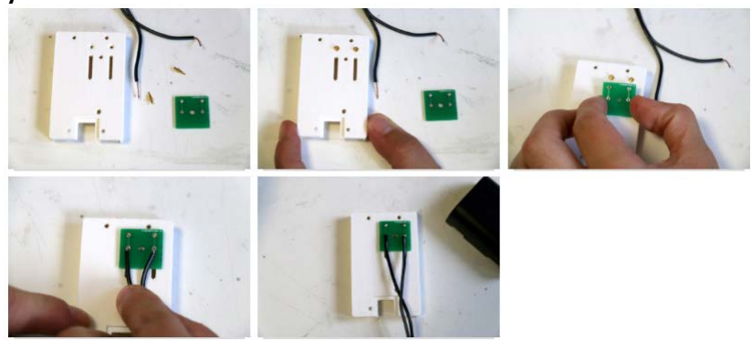
[picture p104: figure]

## Upload code

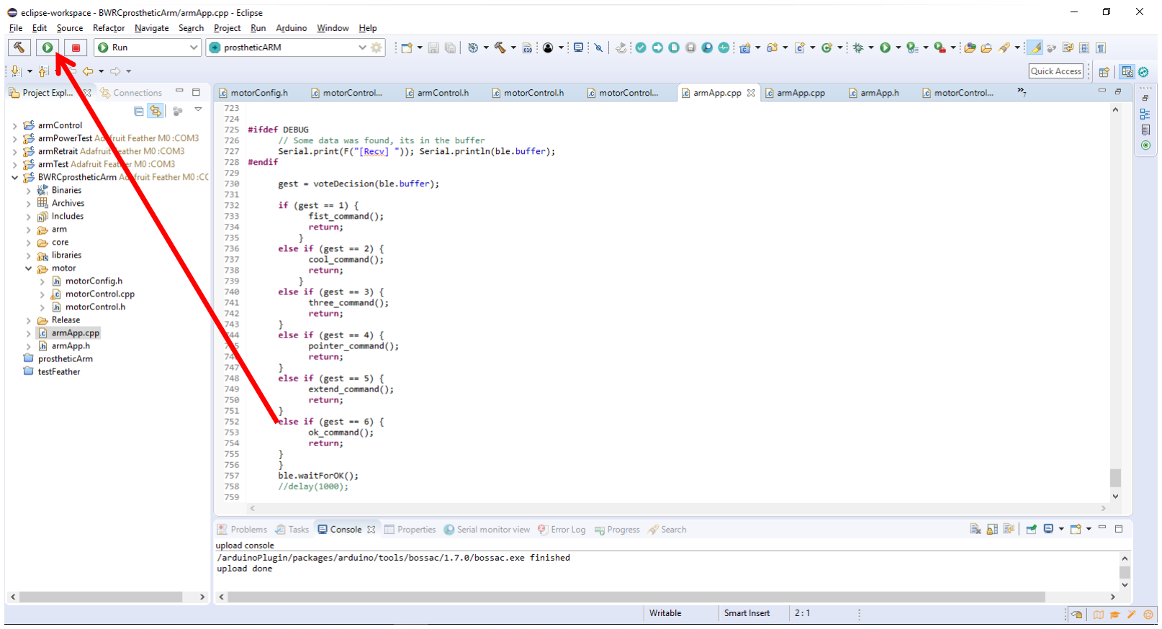
[picture p105: figure]

## How is working now…

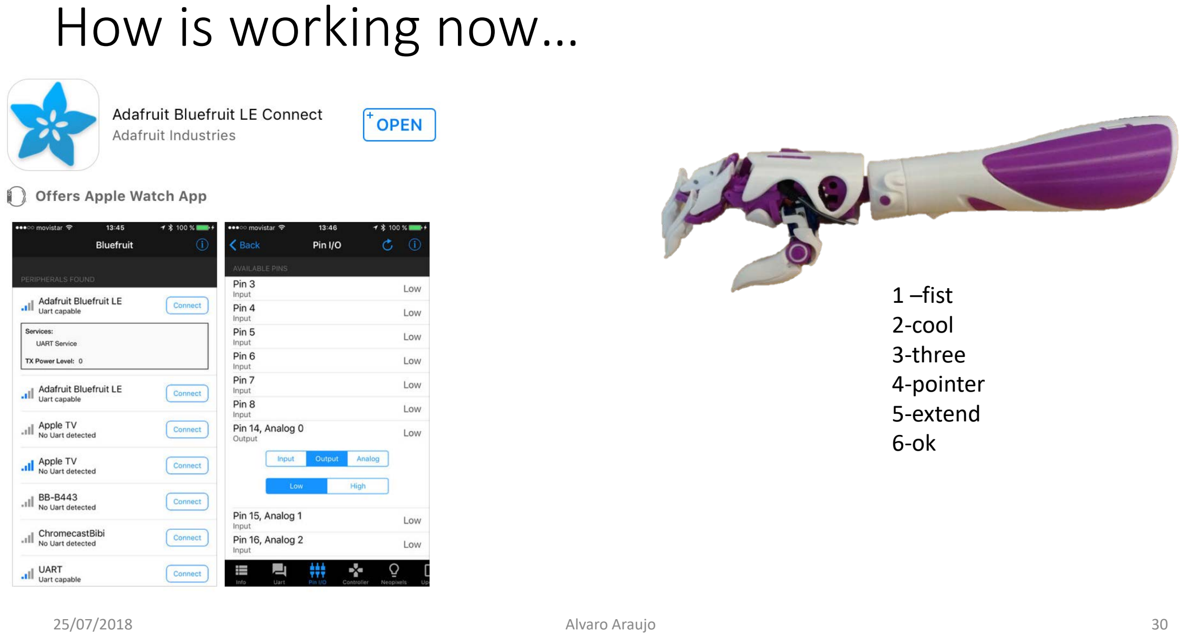
[picture p106: page 30]

1 –fist
2-cool
3-three
4-pointer
5-extend
6-ok

## Architecture

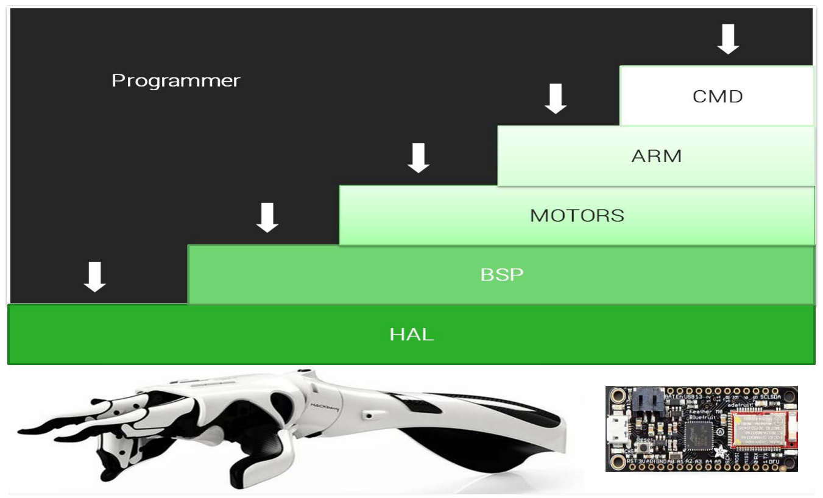
[picture p107: figure]

## Architecture

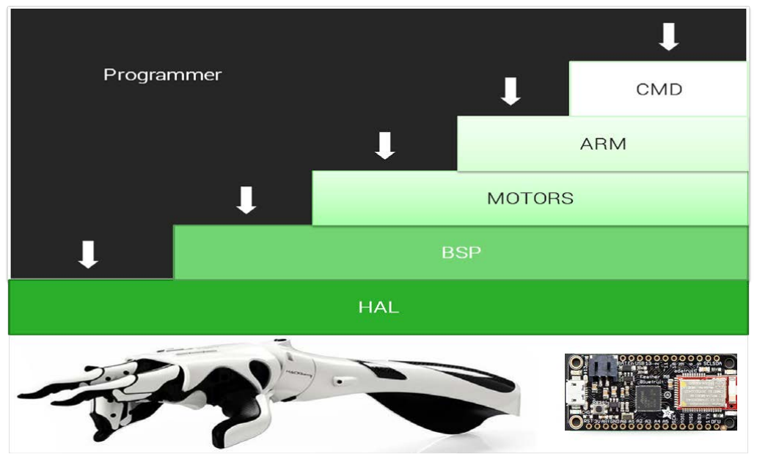
[picture p108: figure]

- Independent
- Arm hardware dependent
- Motor dependent
- Platform/OS dependent
- µP dependent
- Electronics + Mechanical

## Mechanical

- Exiii based (GPL and Creative Commons licenses)

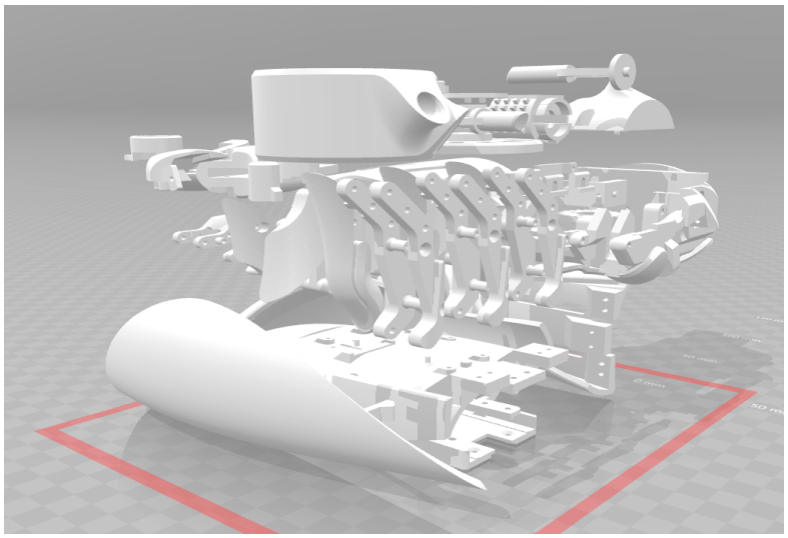
[picture p109: figure]

- http://exiii-hackberry.com/

## Mechanical

- Exiii based

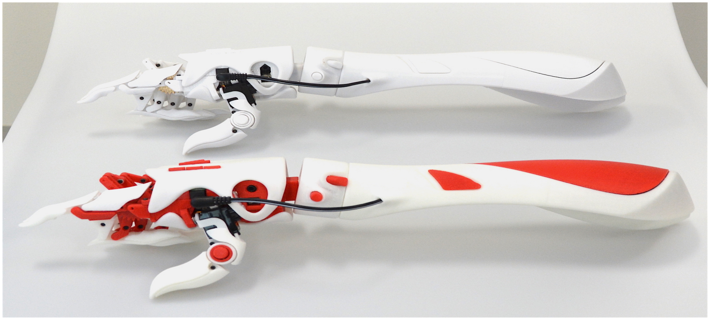
[picture p110: figure]

## Mechanical

- Motors
- Index
- Thumb
- Fingers
- Wrist – elevation
- Wrist – azimut
- Sensor
- Accelerometer XYZ (feedback)

## Electronics

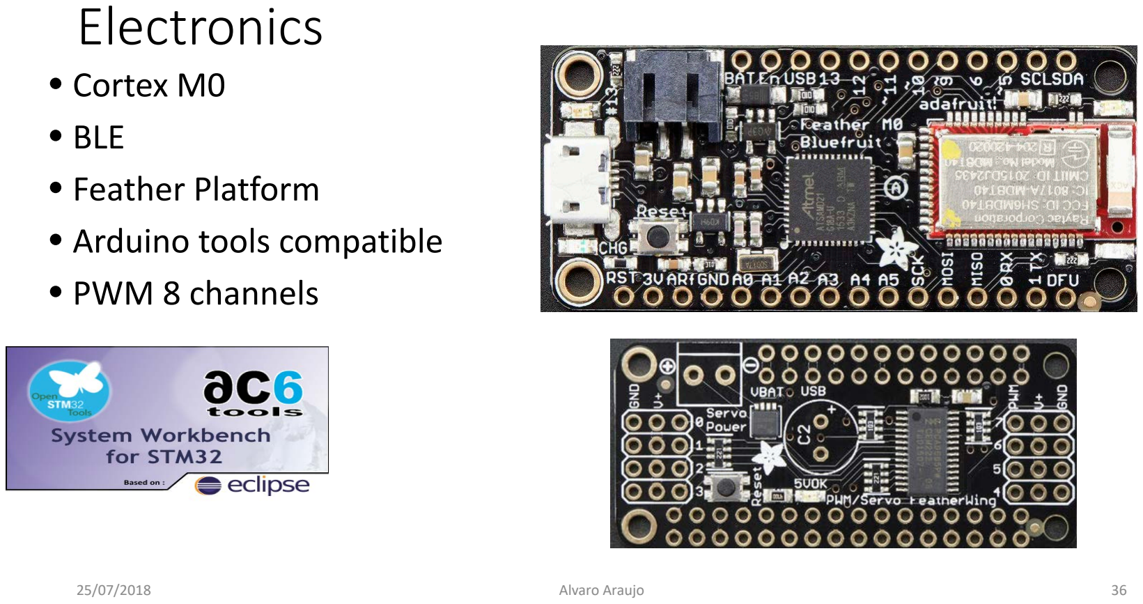
[picture p111: page 36]

- Cortex M0
- BLE
- Feather Platform
- Arduino tools compatible
- PWM 8 channels

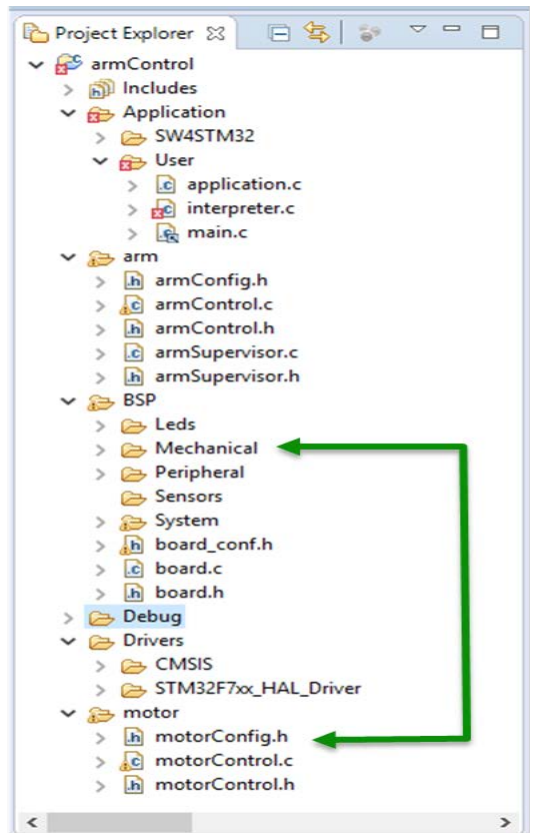
[picture p112: figure]

## SW architecture

- Application
- Arm
- motor
- BSP
- Drivers/HAL

## Motor

- motorConfig.h
- motorControl.h
- motorControl.c

## Motor

- motorConfig.h

## Motor

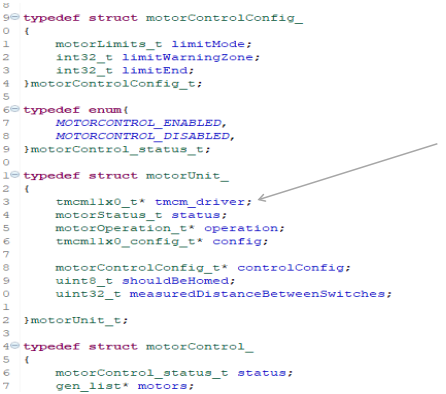
[picture p113: figure]

- motorControl.h

## Motor

- motorControl.h
- motorControl_init (motorControl_t** motorControl);
- motorControl_addMotor (motorControl_t* motorControl, motorUnit_t** motorUnit, tmcm11x0_t* tmcm_motor, tmcm11x0_config_t* motorConfig, motorControlConfig_t* controlConfig);
- motorControl_start (motorControl_t* motorControl);
- motorControl_stop (motorControl_t* motorControl);
- motorControl_unit_moveSteps (motorControl_t* motorControl, motorUnit_t* motorUnit, motorDirection_t direction, uint32_t steps);
- motorControl_unit_position();
- motorControl_unit_setPositioningSpeed();

## Arm

- armConfig.h • armControl.h • armControl.c • armSupervisor.h • armSupervisor.c

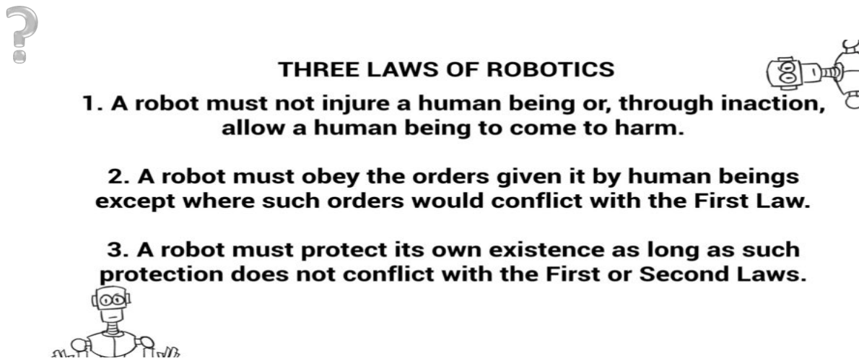
[picture p114: figure]

## Arm

- armConfig.h

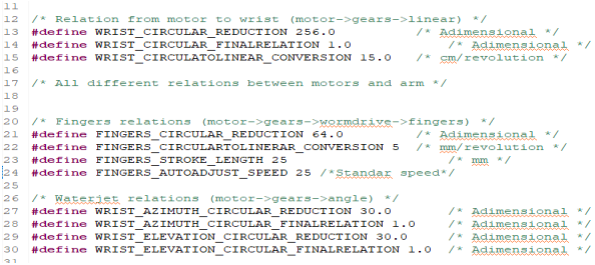
[picture p115: figure]

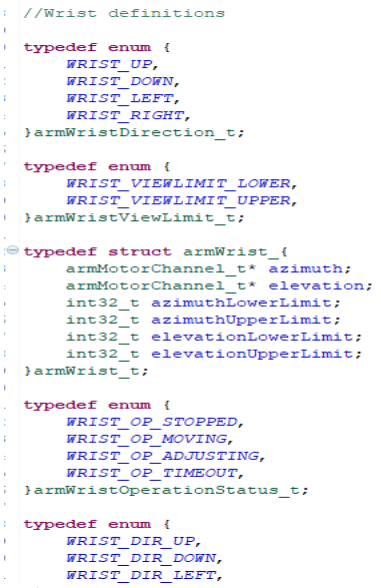
[picture p116: figure]

## Arm

- armControl.h

## Arm

- armControl.h
- armControl_create (armControl_t** armControl);
- armControl_configure (armControl_t* armControl, motorControl_t* motorControl, motorUnit_t* fingers, motorUnit_t* index, motorUnit_t* thumb, motorUnit_t* wristAzimuth, motorUnit_t* wristElevation);
- armControl_getAcceleration();
- armControl_wrist_move (armControl_t* armControl, armWristDirection_t direction, float32_t speed);
- armControl_wrist_position();
- armControl_wrist_stop();
- …

## Application

- Application.c
- Init
- Configuration
- Wait for orders (TxRx/UART…)
- Orders -> Arm Commands

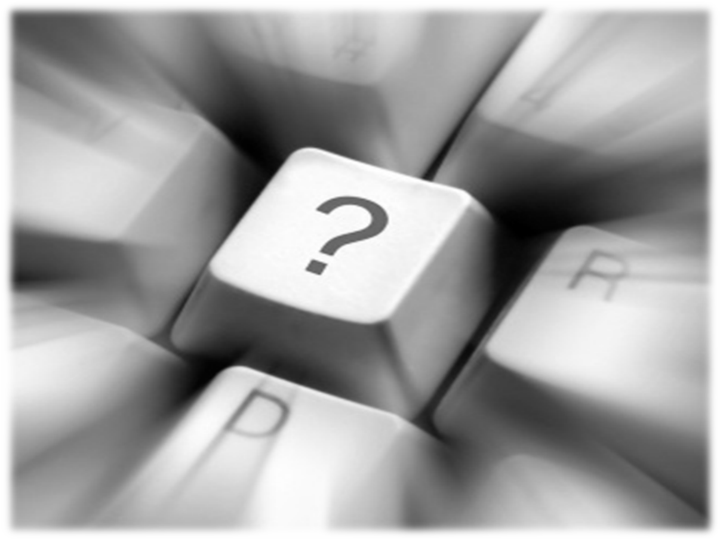
[picture p117: figure]

Alvaro Araujo
araujo@b105.upm.es
araujo@berkeley.edu

## BWRC rocks!!

47
