araujoB105/BWRCprostheticArm/(list of files, drawings)

Other design files:
hardware/batteryBoardaraujo.PcbDoc
hardware/handBoardBWRCaraujo.PcbDoc
