araujoB105/BWRCprostheticArm/software/BWRCprostheticArm/armApp.h

// Only modify this file to include
// - function definitions (prototypes)
// - include files
// - extern variable definitions
// In the appropriate section

#ifndef _armApp_H_
#define _armApp_H_
#include "Arduino.h"

//add your includes for the project armApp here


//end of add your includes here


//add your function definitions for the project armApp here




//Do not add code below this line
#endif /* _testFeather_H_ */
