araujoB105/BWRCprostheticArm/pictures/IMG_20180503_151154_566.jpg

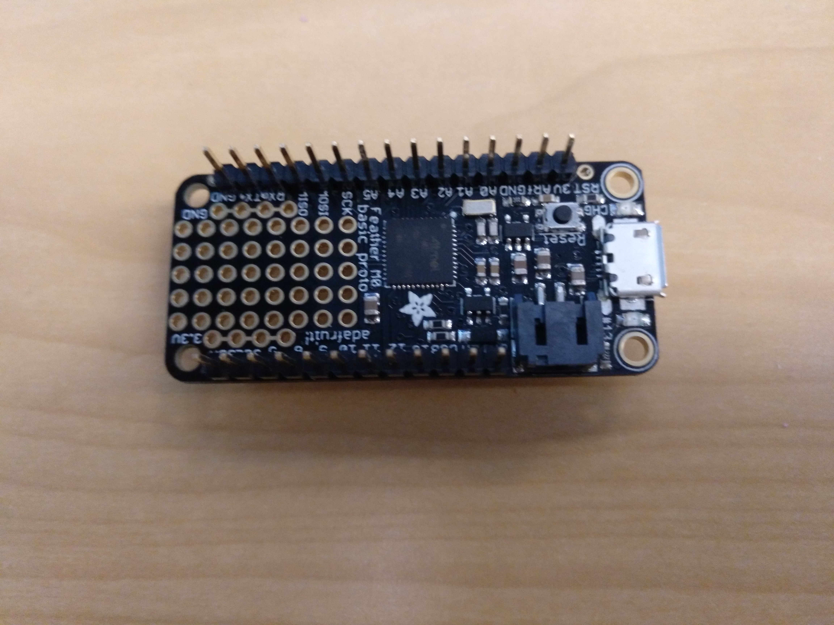
pictures/IMG_20180503_151154_566.jpg
